0x63616c/split-flap/cad/export/renders/mirror-light-layout.png

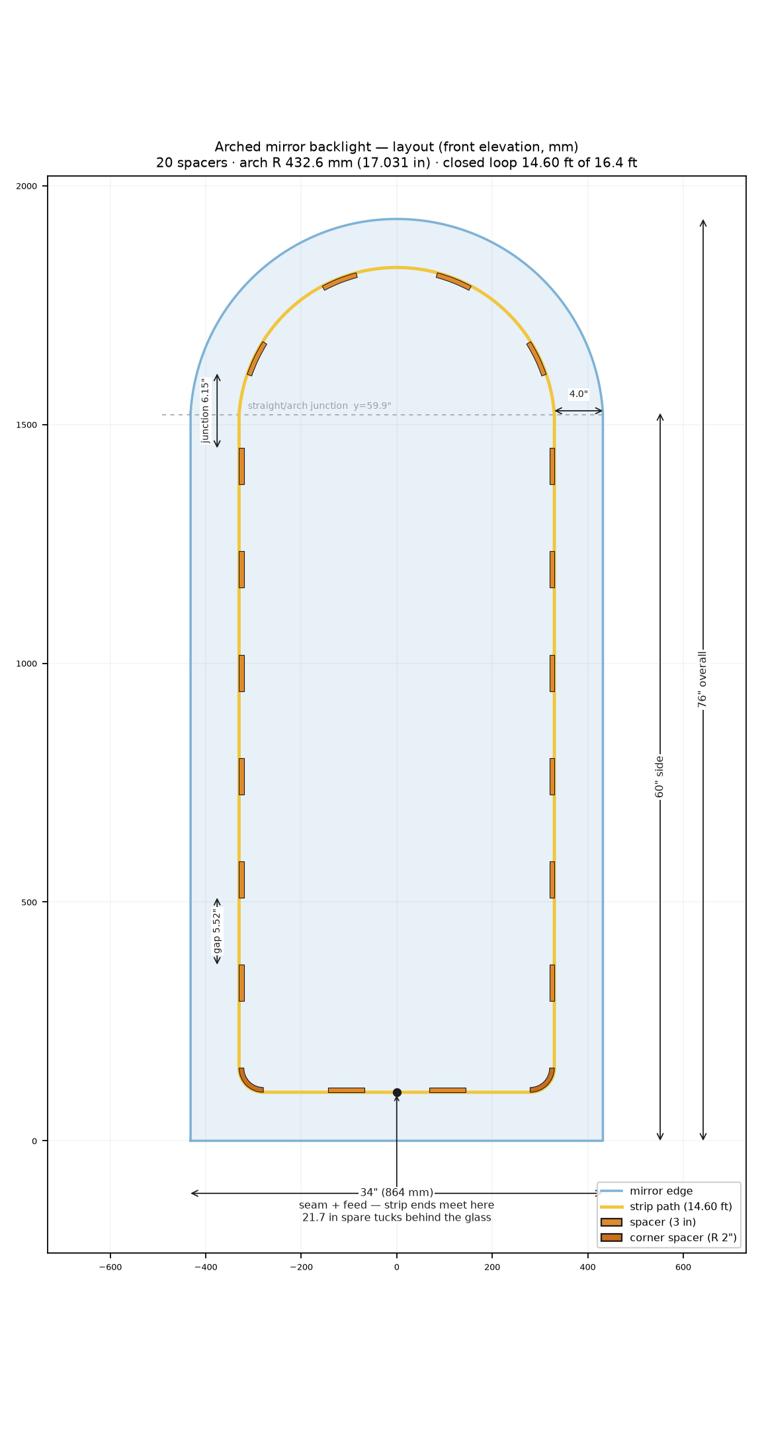
cad/export/renders/mirror-light-layout.png
