0x63616c/split-flap/cad/export/renders/mirror-light-section.png

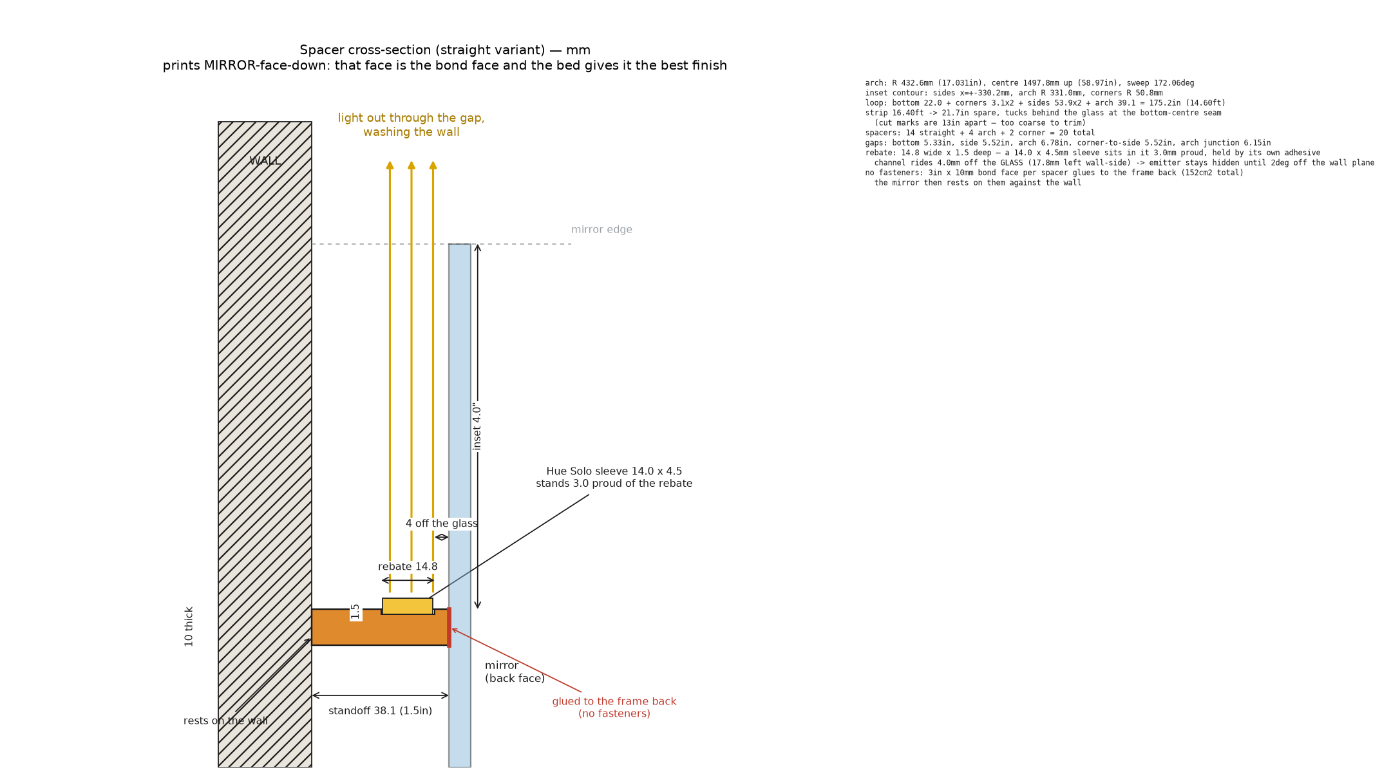
cad/export/renders/mirror-light-section.png
