0x63616c/split-flap/pcb/driver-board-nema/render/bottom.png

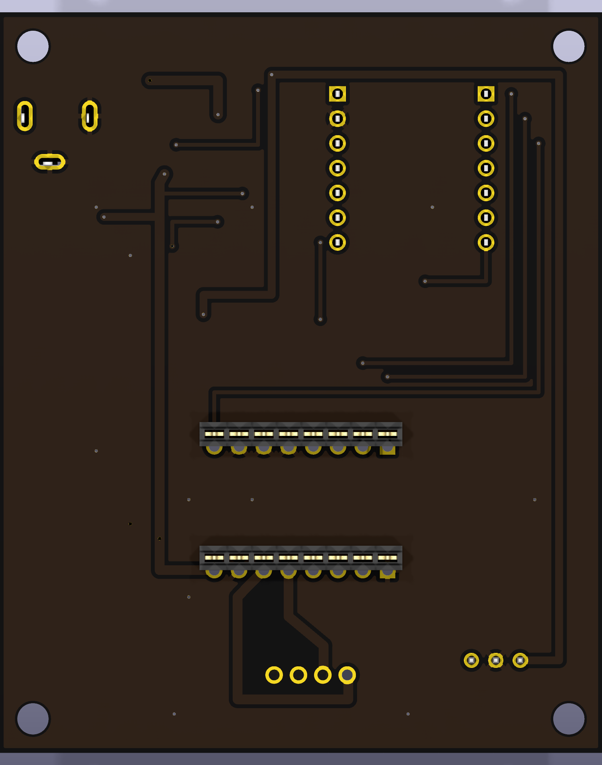
pcb/driver-board-nema/render/bottom.png
