0x63616c/split-flap/pcb/driver-board-nema/render/front.png

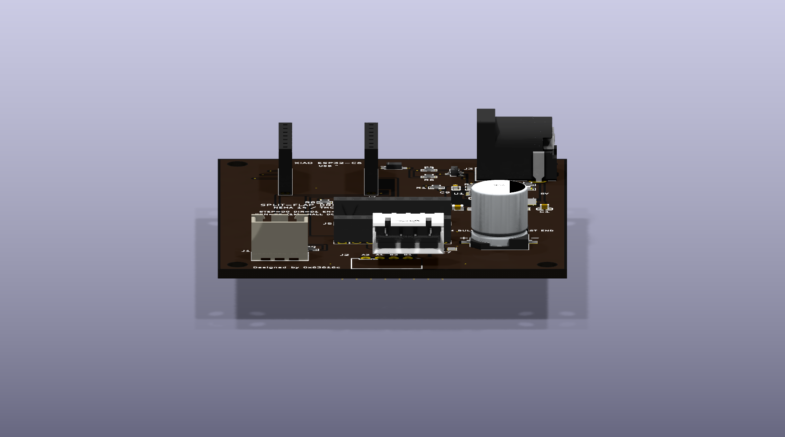
pcb/driver-board-nema/render/front.png
