0x63616c/split-flap/pcb/driver-board-nema/render/iso.png

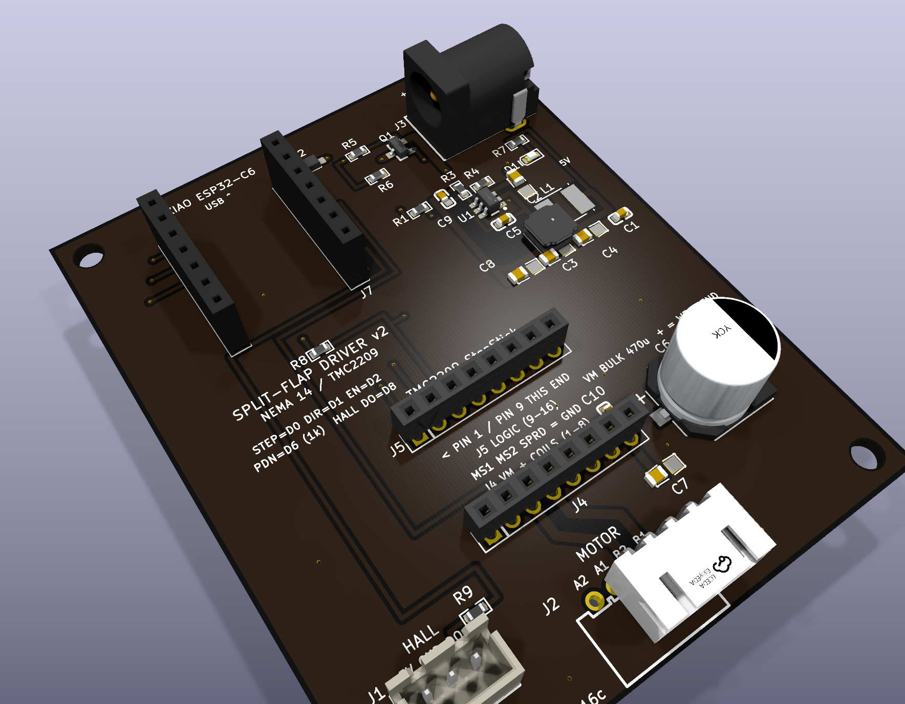
pcb/driver-board-nema/render/iso.png
