0x63616c/split-flap/pcb/driver-board/render/bottom.png

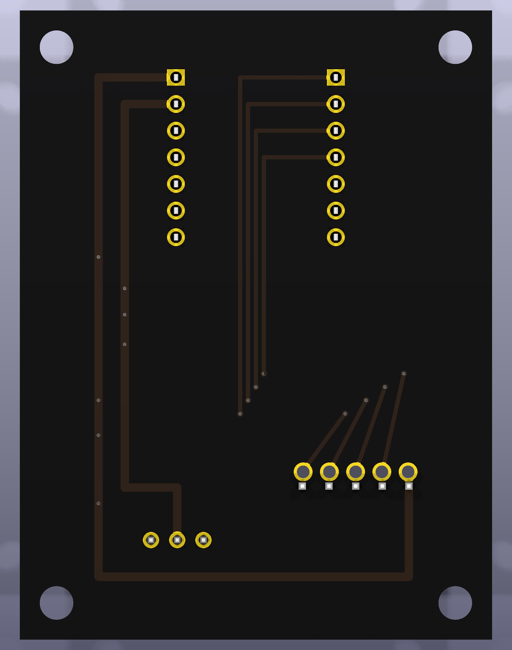
pcb/driver-board/render/bottom.png
