0x63616c/split-flap/pcb/driver-board/render/front.png

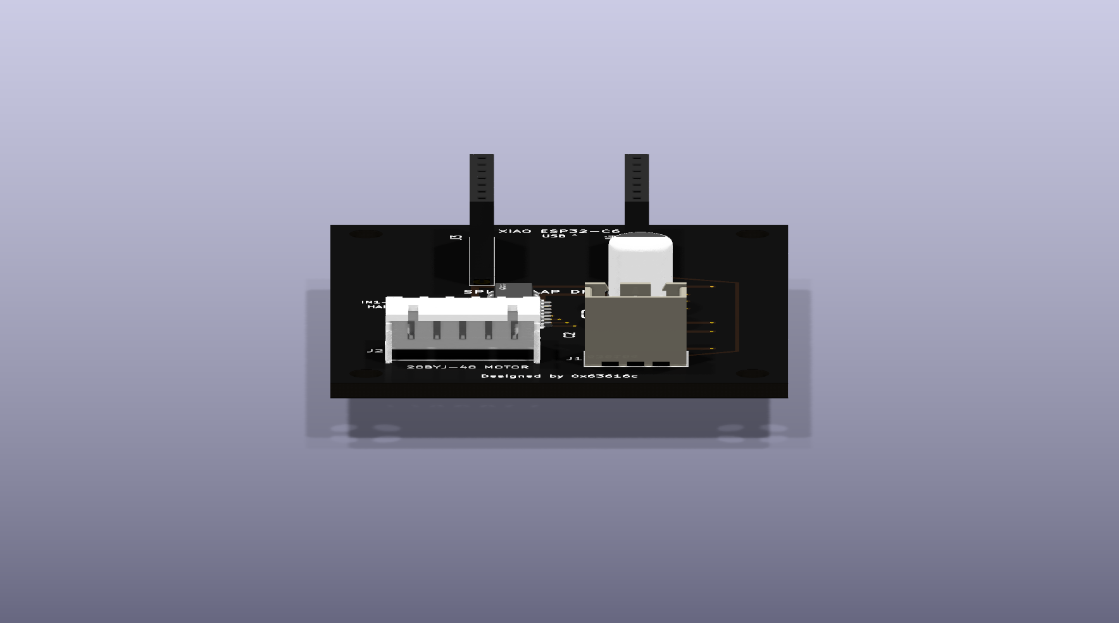
pcb/driver-board/render/front.png
