0x63616c/split-flap/pcb/driver-board/render/iso2.png

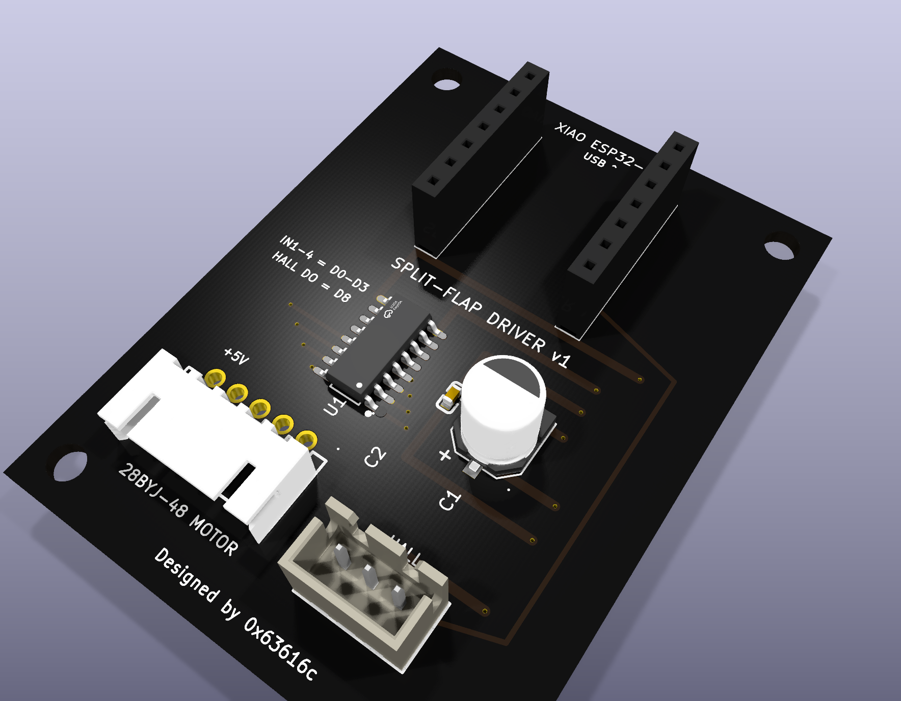
pcb/driver-board/render/iso2.png
