0x63616c/split-flap/pcb/driver-board/render/iso.png

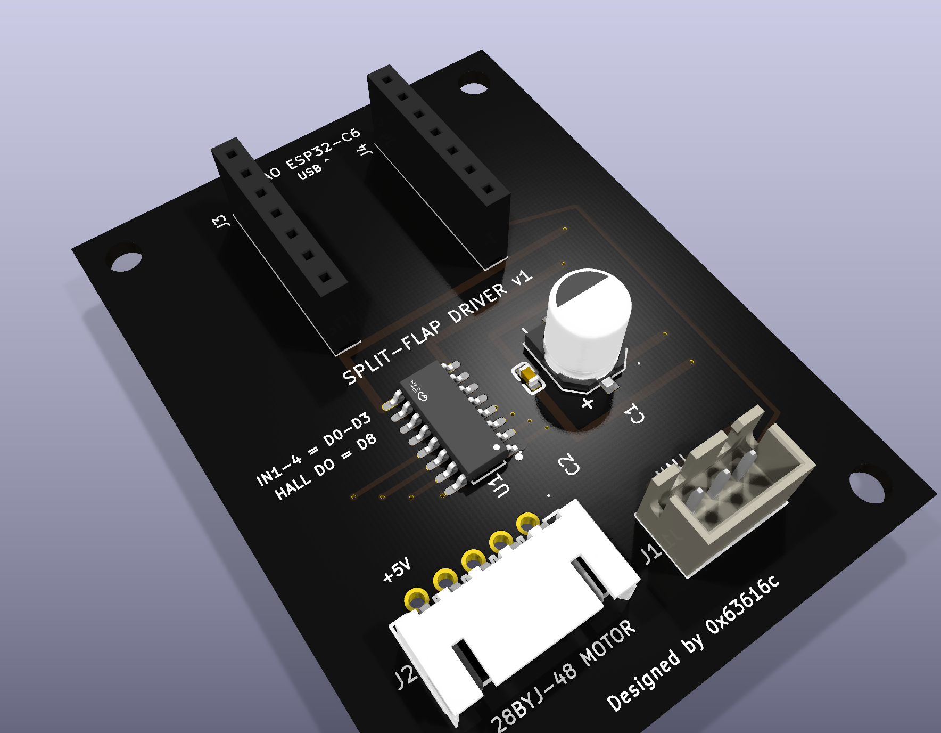
pcb/driver-board/render/iso.png
