0x63616c/split-flap/docs/inventory.md

# Inventory — supplies on hand

As of 2026-07-14. The BOM (`bom/module-bom.md`) reconciles against this list. Everything not listed here is to be 3D-printed on the P2S.

## Electronics / actuation

| Item | Qty | Notes |
|---|---|---|
| Seeed XIAO ESP32-C6 | ~2 | Controller. RISC-V, WiFi/BLE. 11 GPIO broken out (D0–D10), VBUS 5V pin, 3.3V-OUT, USB-C |
| ELEGOO 28BYJ-48 5V stepper + ULN2003 driver board | 5 sets | Drum drive |
| FORIOT A3144 / 3144E Hall-effect sensors | 10 | 3.3–5V; flap homing |
| ELEGOO 400-point solderless breadboards | 6 | Prototype wiring |
| Soldering iron set | 1 | In bag, contents unconfirmed |
| Klein Tools MM420 multimeter | 1 | Cheatsheet: `docs/reference/klein-mm420.md`, manual PDF alongside |

## Fasteners / hardware

| Item | Qty | Notes |
|---|---|---|
| M3 brass heat-set threaded inserts | 300 | M3 × 3–10 mm height, 4.5 mm OD; for printed parts |
| M3 button-head hex socket screws (assortment) | 1001 | 6/8/10/12/16/20/25/30 mm + nuts + washers, 10.9 alloy |
| rhinocats 6×3 mm round rare-earth magnets | 80 | Known magnet stock (other "small magnets" mentioned but unconfirmed) |

## Fabrication

| Item | Notes |
|---|---|
| Bambu Lab P2S printer | P1S-class; slicer is Bambu Studio |
| Filament | White + black |
