0x63616c/split-flap/cad/export/lid-clip.stl

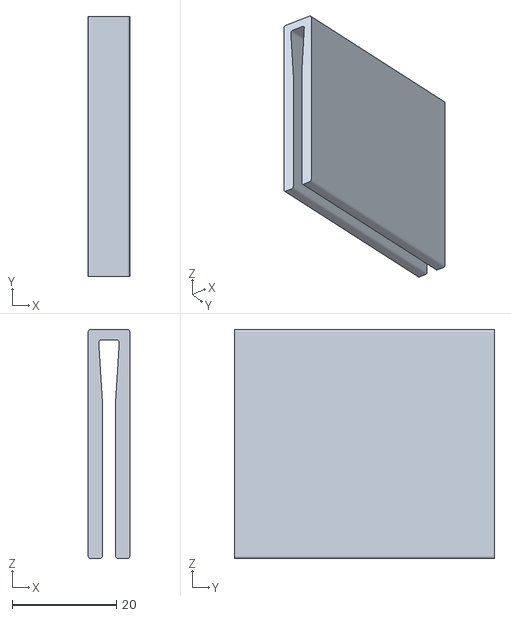
[picture p13: CAD file, 2026-07-22]
cad/export/lid-clip.stl
8.00 x 50.0 x 44.0
