0x63616c/split-flap/cad/export/plates/flaps_plate_4.3mf

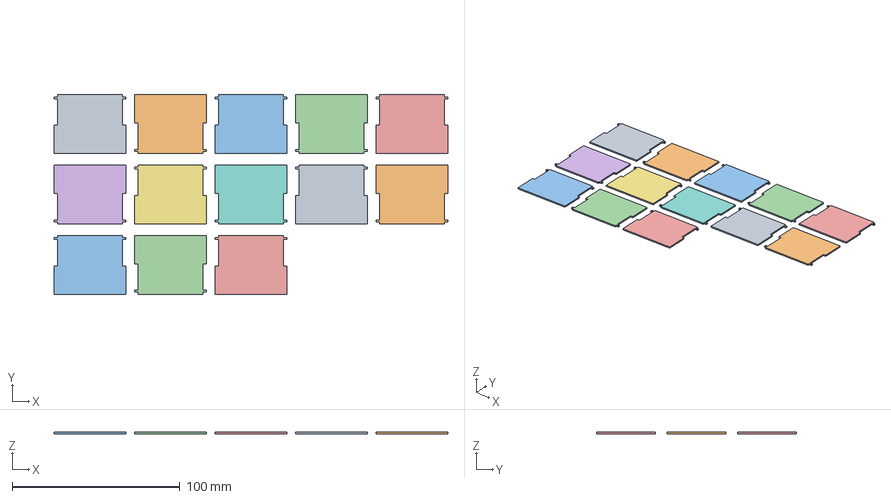
[picture p14: CAD file, 2026-07-22]
cad/export/plates/flaps_plate_4.3mf
235.0 x 119.0 x 1.00 mm
flap_39_hyphen_qmark
flap_40_qmark_bang
flap_41_bang_dollar
flap_42_dollar_gbp
flap_43_gbp_hash
flap_44_hash_pct
flap_45_pct_deg
flap_46_deg_apos
flap_47_apos_amp
flap_48_amp_slash
flap_49_slash_plus
flap_50_plus_comma
flap_51_comma_blank
