0x63616c/split-flap/cad/export/lid-clip-post.stl

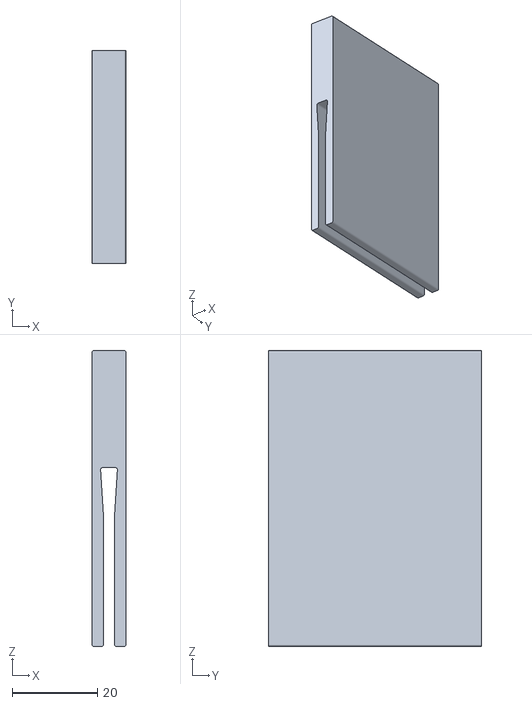
[picture p16: CAD file, 2026-07-22]
cad/export/lid-clip-post.stl
8.00 x 50.0 x 69.5
