0x63616c/split-flap/cad/export/plates/flaps_plate_2.3mf

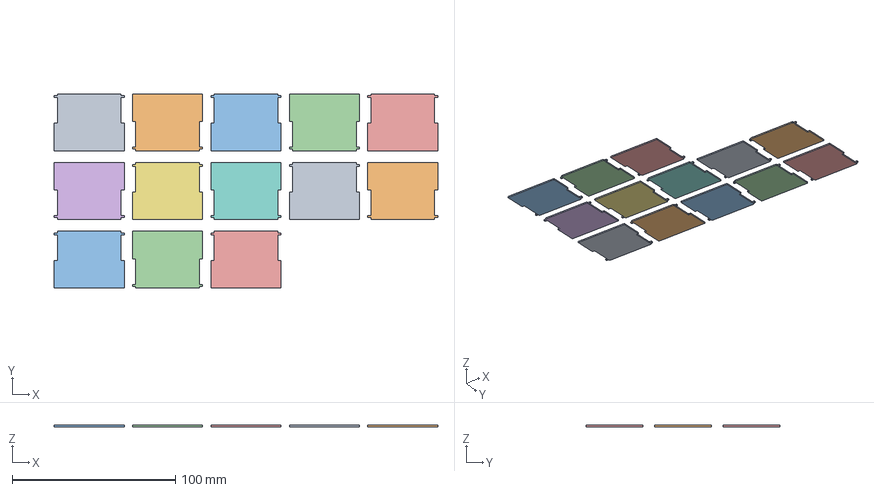
[picture p17: CAD file, 2026-07-22]
cad/export/plates/flaps_plate_2.3mf
235.0 x 119.0 x 1.00 mm
flap_13_MN
flap_14_NO
flap_15_OP
flap_16_PQ
flap_17_QR
flap_18_RS
flap_19_ST
flap_20_TU
flap_21_UV
flap_22_VW
flap_23_WX
flap_24_XY
flap_25_YZ
