0x63616c/split-flap/cad/export/box-corner.stl

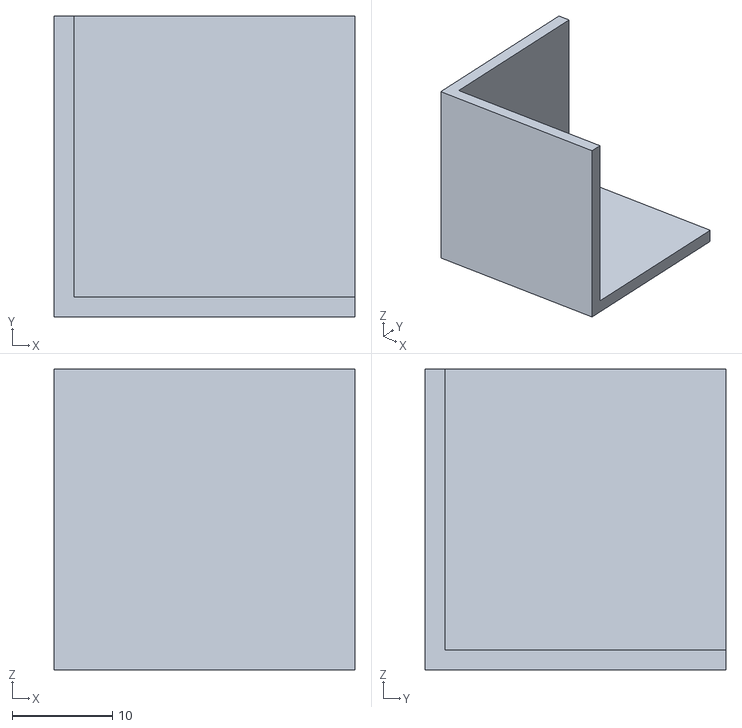
[picture p18: CAD file, 2026-07-22]
cad/export/box-corner.stl
30.0 x 30.0 x 30.0
