0x63616c/split-flap/cad/export/plates/flaps_plate_1.3mf

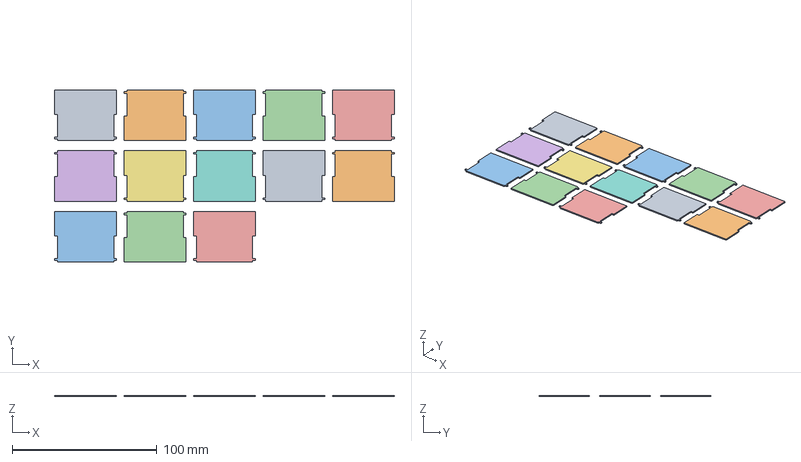
[picture p20: CAD file, 2026-07-22]
cad/export/plates/flaps_plate_1.3mf
235.0 x 119.0 x 1.00 mm
flap_00_blank_A
flap_01_AB
flap_02_BC
flap_03_CD
flap_04_DE
flap_05_EF
flap_06_FG
flap_07_GH
flap_08_HI
flap_09_IJ
flap_10_JK
flap_11_KL
flap_12_LM
