0x63616c/split-flap/cad/export/mirror-spacer-straight.stl

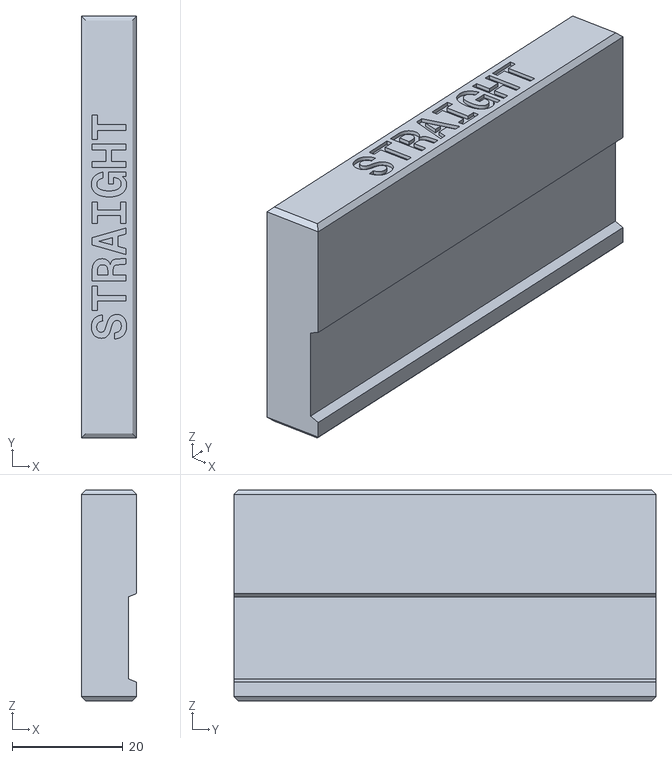
[picture p21: CAD file, 2026-07-21]
cad/export/mirror-spacer-straight.stl
10.0 x 76.2 x 38.1
