0x63616c/split-flap/cad/export/plates/flaps_plate_3.3mf

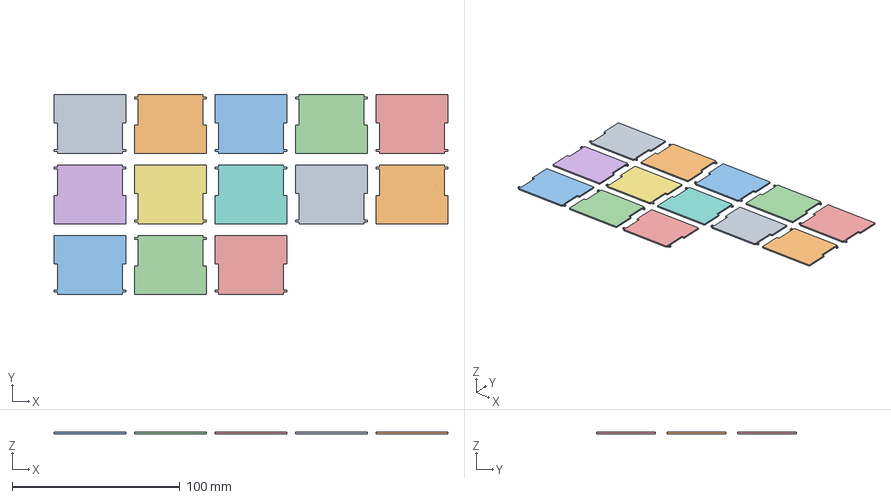
[picture p22: CAD file, 2026-07-17]
cad/export/plates/flaps_plate_3.3mf
235.0 x 119.0 x 1.00 mm
flap_26_Z0
flap_27_01
flap_28_12
flap_29_23
flap_30_34
flap_31_45
flap_32_56
flap_33_67
flap_34_78
flap_35_89
flap_36_9_colon
flap_37_colon_period
flap_38_period_hyphen
