0x63616c/split-flap/cad/export/mirror-spacer-arch.stl

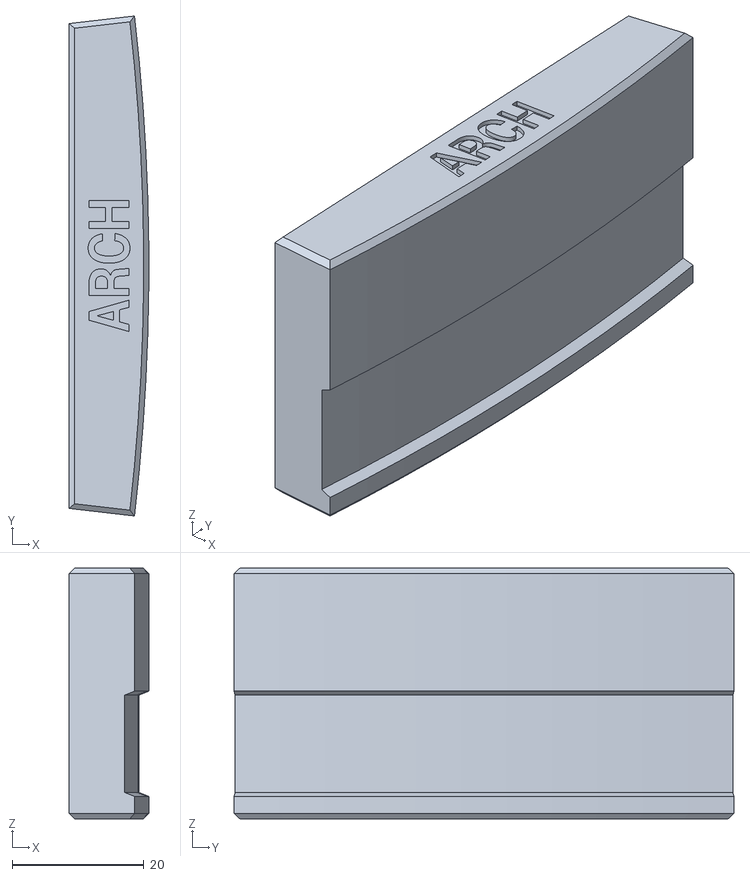
[picture p24: CAD file, 2026-07-21]
cad/export/mirror-spacer-arch.stl
12.1 x 76.0 x 38.1
