0x63616c/split-flap/cad/export/unit.stl

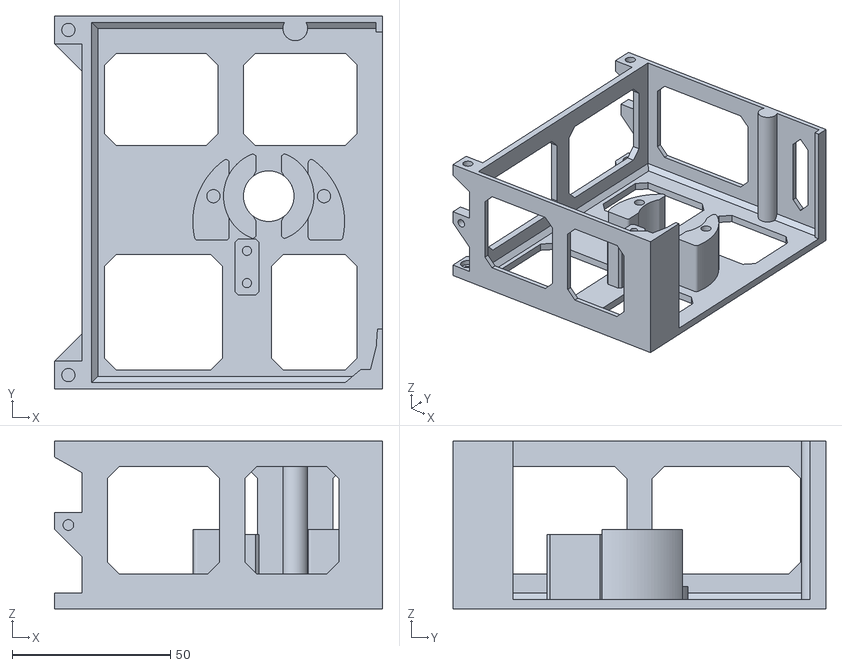
[picture p26: CAD file, 2026-07-21]
cad/export/unit.stl
103.8 x 118.0 x 53.0
