0x63616c/split-flap/cad/export/flaps/flap_22_VW.3mf

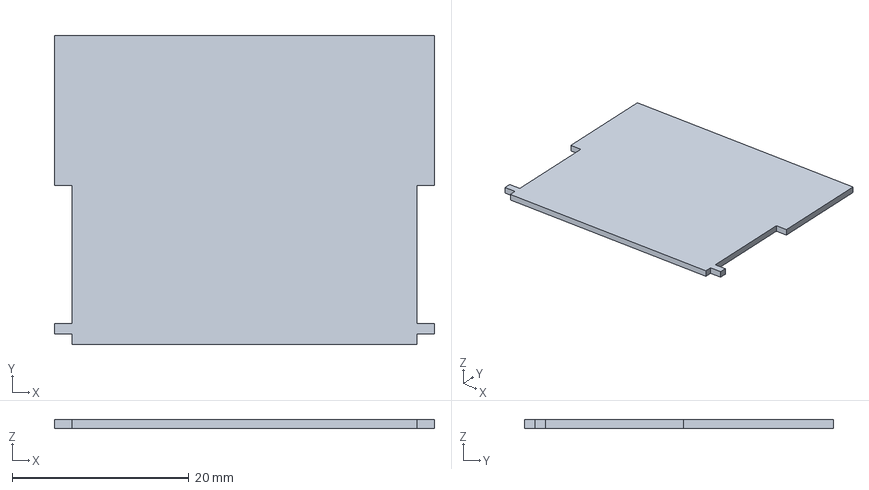
[picture p27: CAD file, 2026-07-18]
cad/export/flaps/flap_22_VW.3mf
43.0 x 35.0 x 1.00 mm
