0x63616c/split-flap/cad/export/mirror-spacer-corner.stl

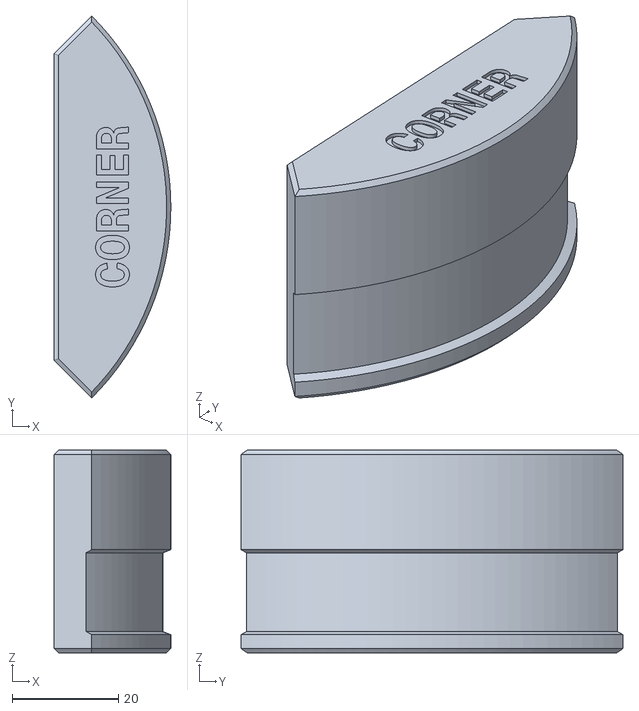
[picture p28: CAD file, 2026-07-21]
cad/export/mirror-spacer-corner.stl
22.0 x 71.8 x 38.1
