0x63616c/split-flap/cad/export/flaps/flap_23_WX.3mf

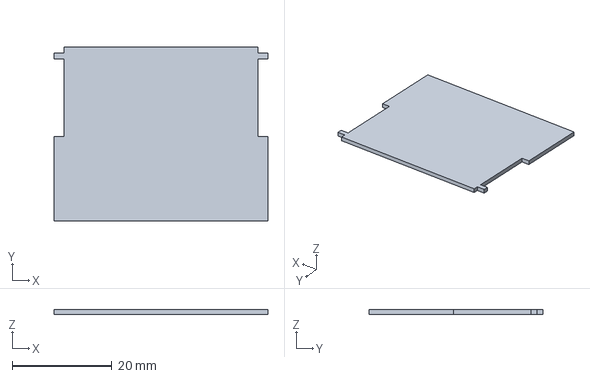
[picture p29: CAD file, 2026-07-17]
cad/export/flaps/flap_23_WX.3mf
43.0 x 35.0 x 1.00 mm
