0x63616c/split-flap/cad/export/poop-bucket.stl

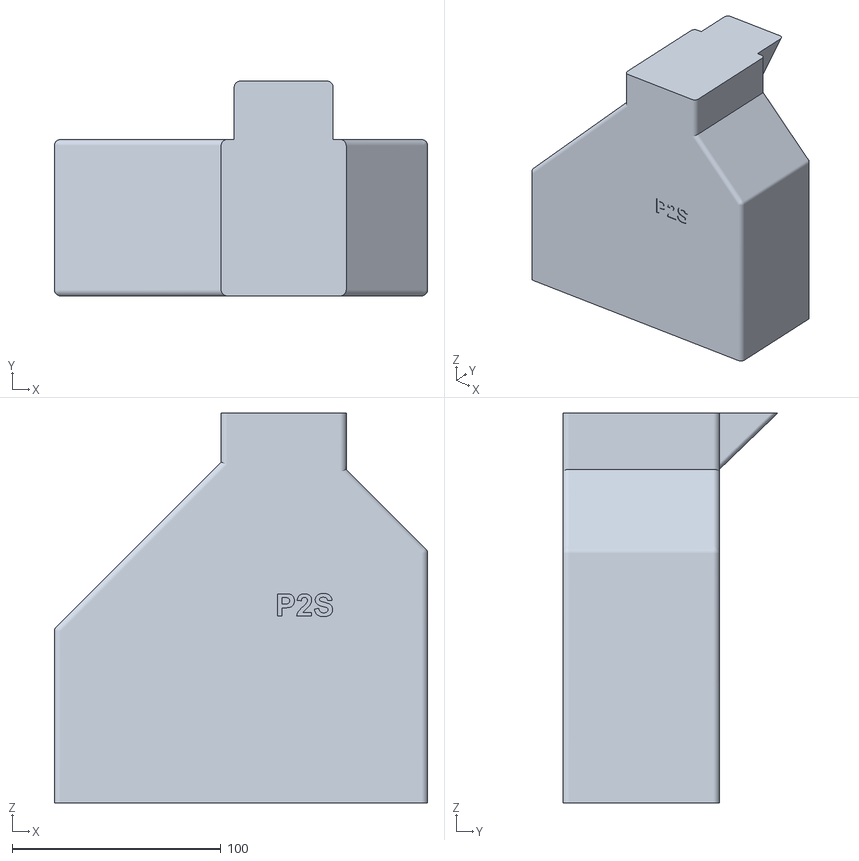
[picture p30: CAD file, 2026-07-19]
cad/export/poop-bucket.stl
179.0 x 103.0 x 187.0
