0x63616c/split-flap/cad/export/grommet-bathroom.stl

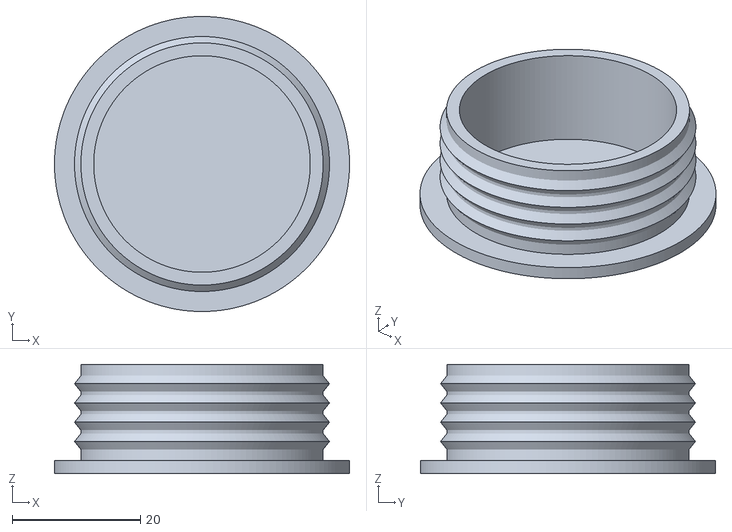
[picture p31: CAD file, 2026-07-19]
cad/export/grommet-bathroom.stl
46.0 x 46.0 x 17.0
