0x63616c/split-flap/cad/export/unit-nema.stl

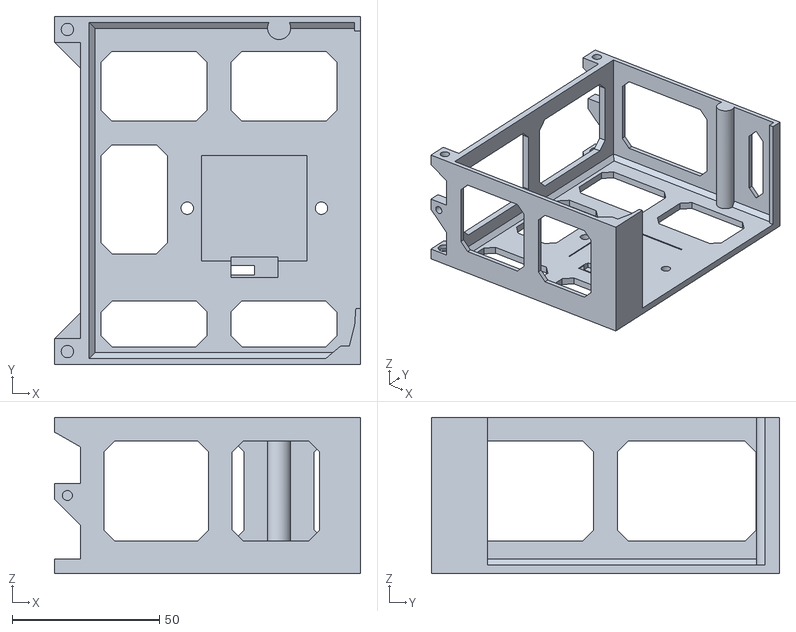
[picture p33: CAD file, 2026-07-18]
cad/export/unit-nema.stl
103.8 x 118.0 x 53.0
