0x63616c/split-flap/cad/export/bridge-nema.stl

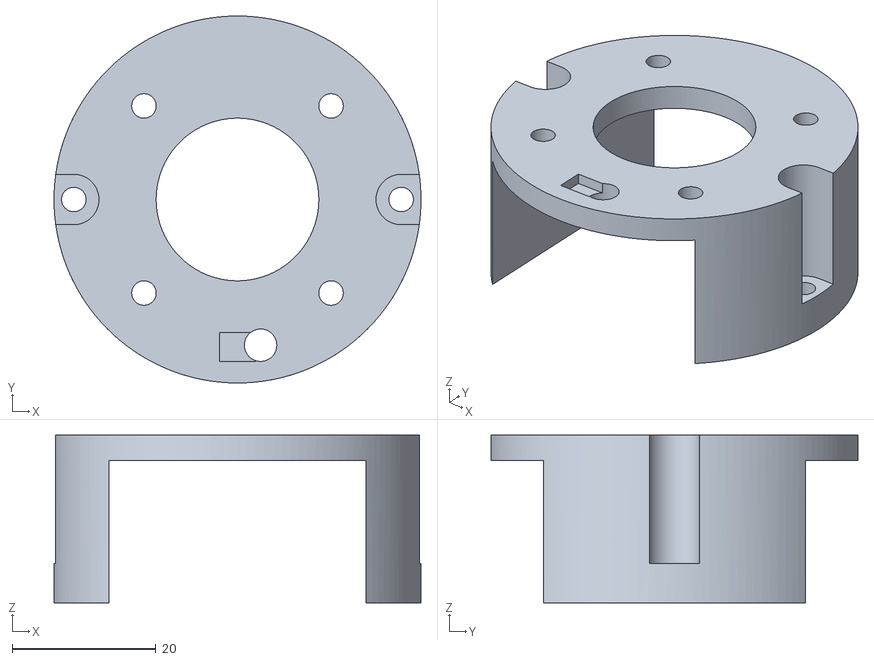
[picture p34: CAD file, 2026-07-18]
cad/export/bridge-nema.stl
51.0 x 51.0 x 23.3
