0x63616c/split-flap/cad/export/drum-inner-nema.stl

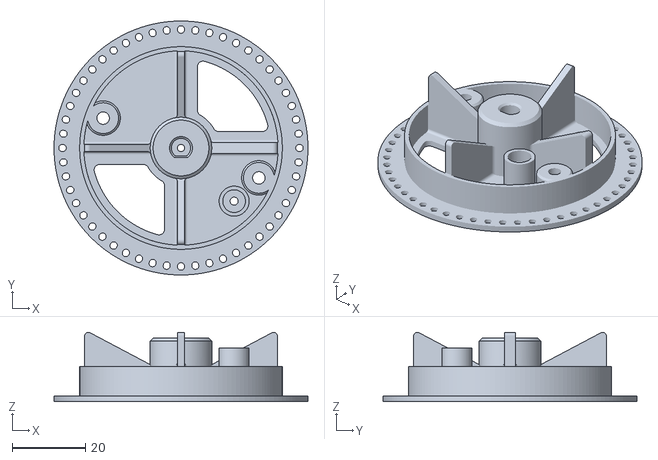
[picture p36: CAD file, 2026-07-18]
cad/export/drum-inner-nema.stl
69.3 x 69.3 x 18.9
