0x63616c/split-flap/cad/export/flaps/flap_16_PQ.3mf

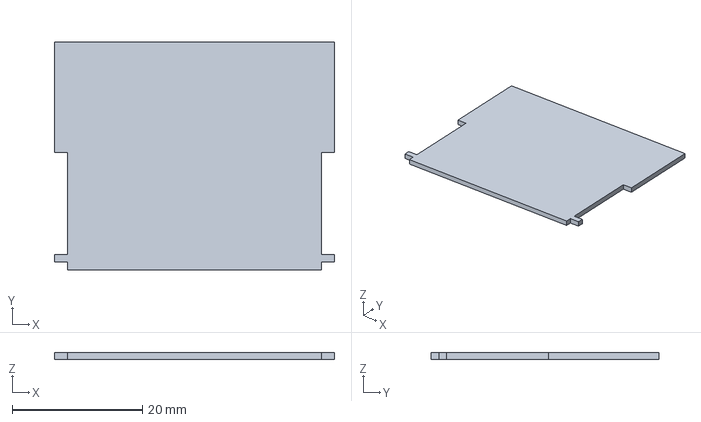
[picture p37: CAD file, 2026-07-17]
cad/export/flaps/flap_16_PQ.3mf
43.0 x 35.0 x 1.00 mm
