0x63616c/split-flap/cad/export/grommet-usb.stl

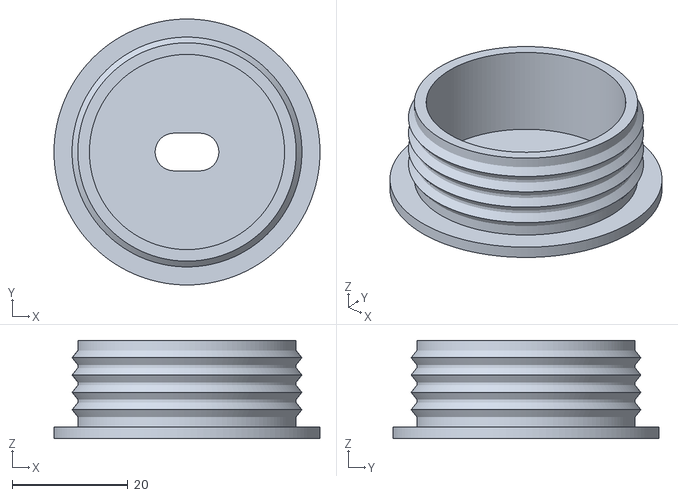
[picture p38: CAD file, 2026-07-18]
cad/export/grommet-usb.stl
46.0 x 46.0 x 17.0
