0x63616c/split-flap/cad/export/ipad-lid.stl

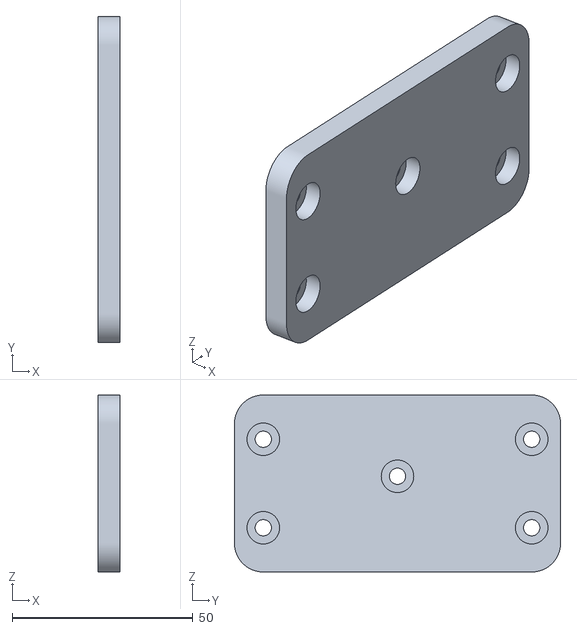
[picture p40: CAD file, 2026-07-17]
cad/export/ipad-lid.stl
6.00 x 90.3 x 49.0
