0x63616c/split-flap/cad/export/ipad-body.stl

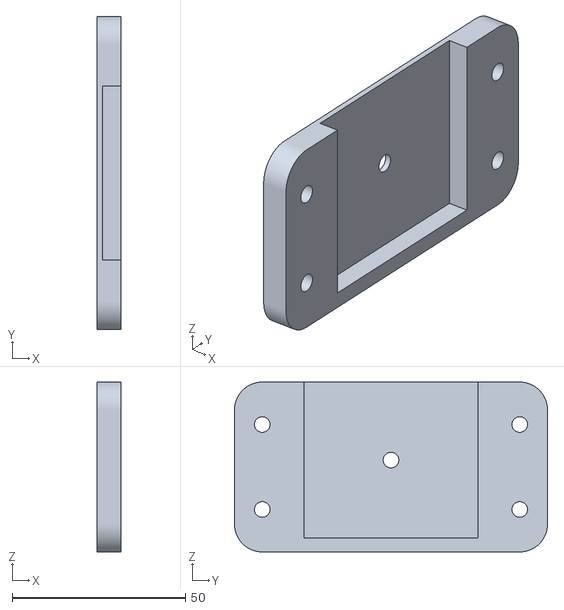
[picture p42: CAD file, 2026-07-17]
cad/export/ipad-body.stl
6.80 x 90.3 x 49.0
