0x63616c/split-flap/cad/export/ipad-bracket.stl

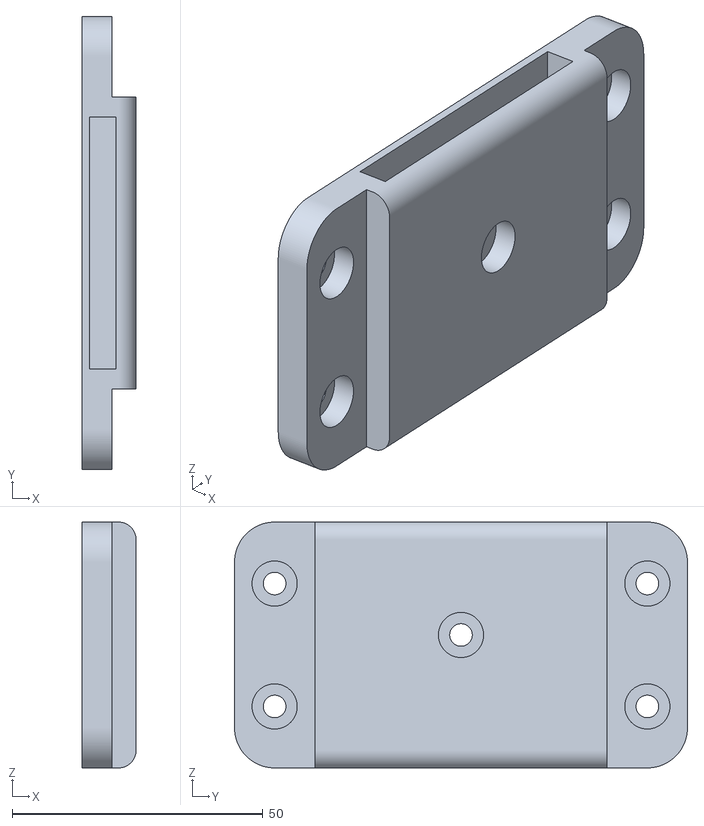
[picture p43: CAD file, 2026-07-17]
cad/export/ipad-bracket.stl
10.8 x 90.3 x 49.0
