0x63616c/split-flap/cad/export/drum-outer.stl

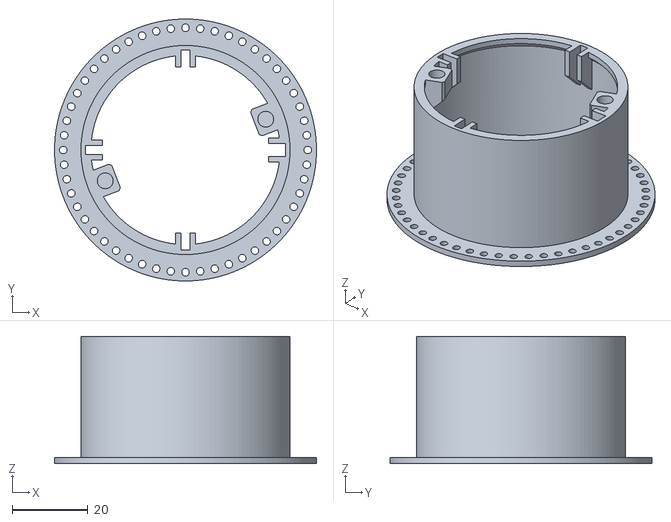
[picture p44: CAD file, 2026-07-17]
cad/export/drum-outer.stl
69.3 x 69.3 x 33.6
