0x63616c/split-flap/cad/export/holder.stl

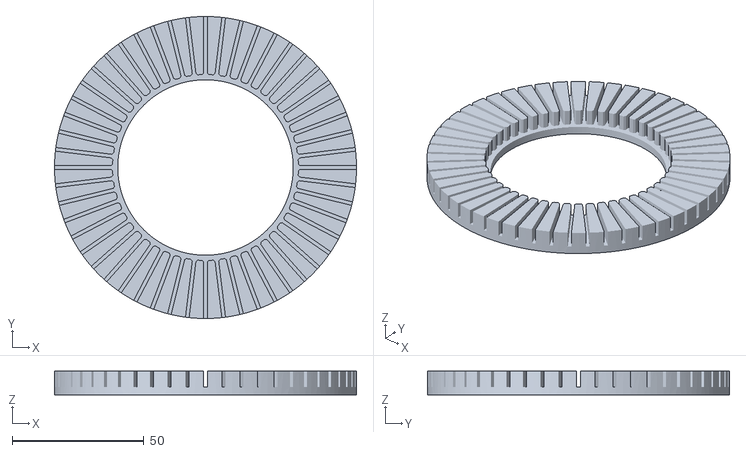
[picture p46: CAD file, 2026-07-17]
cad/export/holder.stl
114.5 x 114.5 x 9.00
