0x63616c/split-flap/cad/export/flap.stl

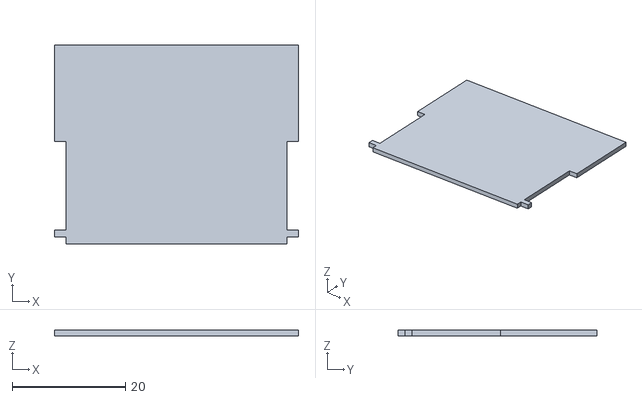
[picture p47: CAD file, 2026-07-16]
cad/export/flap.stl
43.0 x 35.0 x 1.00
