0x63616c/split-flap/cad/export/flaps/flap_45_pct_deg.3mf

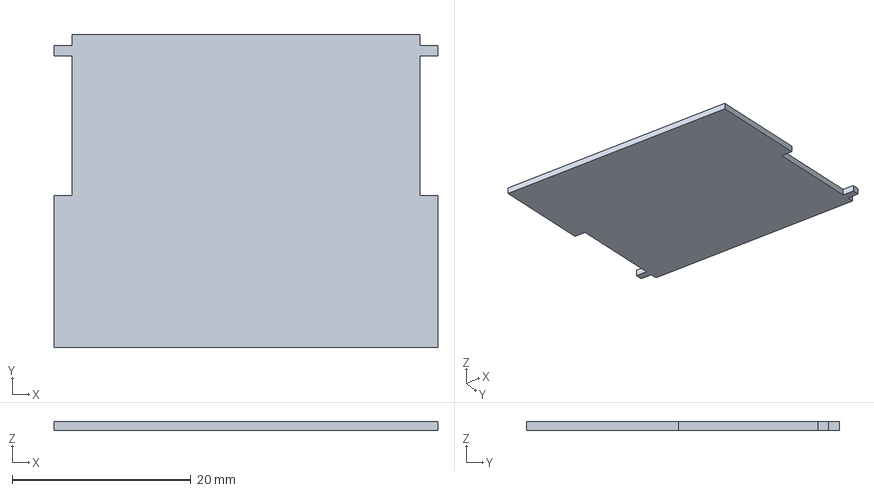
[picture p49: CAD file, 2026-07-17]
cad/export/flaps/flap_45_pct_deg.3mf
43.0 x 35.0 x 1.00 mm
