0x63616c/split-flap/cad/export/flaps/flap_48_amp_slash.3mf

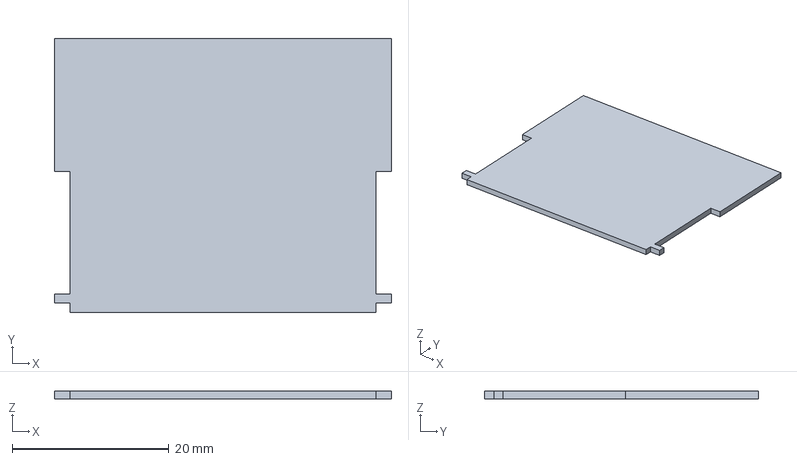
[picture p51: CAD file, 2026-07-17]
cad/export/flaps/flap_48_amp_slash.3mf
43.0 x 35.0 x 1.00 mm
