0x63616c/split-flap/(list of files, cad)

Other CAD files:
cad/export/flaps/flap_21_UV.3mf
cad/export/flaps/flap_31_45.3mf
cad/export/flaps/flap_03_CD.3mf
cad/export/drum-inner-byj.stl
cad/export/flaps/flap_27_01.3mf
cad/export/flaps/flap_49_slash_plus.3mf
cad/export/flaps/flap_47_apos_amp.3mf
cad/export/flaps/flap_15_OP.3mf
cad/export/flaps/flap_19_ST.3mf
cad/export/flaps/flap_06_FG.3mf
cad/export/flaps/flap_51_comma_blank.3mf
cad/export/flaps/flap_42_dollar_gbp.3mf
cad/export/flaps/flap_05_EF.3mf
cad/export/flaps/flap_24_XY.3mf
cad/export/flaps/flap_30_34.3mf
cad/export/flaps/flap_26_Z0.3mf
cad/export/flaps/flap_32_56.3mf
cad/export/flaps/flap_43_gbp_hash.3mf
cad/export/flaps/flap_28_12.3mf
cad/export/flaps/flap_37_colon_period.3mf
cad/export/flaps/flap_36_9_colon.3mf
cad/export/flaps/flap_18_RS.3mf
cad/export/flaps/flap_44_hash_pct.3mf
cad/export/flaps/flap_07_GH.3mf
cad/export/flaps/flap_09_IJ.3mf
cad/export/flaps/flap_11_KL.3mf
cad/export/flaps/flap_01_AB.3mf
cad/export/flaps/flap_35_89.3mf
cad/export/flaps/flap_08_HI.3mf
cad/export/flaps/flap_17_QR.3mf
cad/export/flaps/flap_38_period_hyphen.3mf
cad/export/flaps/flap_41_bang_dollar.3mf
cad/export/flaps/flap_04_DE.3mf
cad/export/flaps/flap_34_78.3mf
cad/export/flaps/flap_20_TU.3mf
cad/export/flaps/flap_02_BC.3mf
