0x63616c/split-flap/pcb/driver-board-nema/layouts/default/default.kicad_pcb

## KiCad design pcb/driver-board-nema/layouts/default/default.kicad_pcb (2026-07-19)

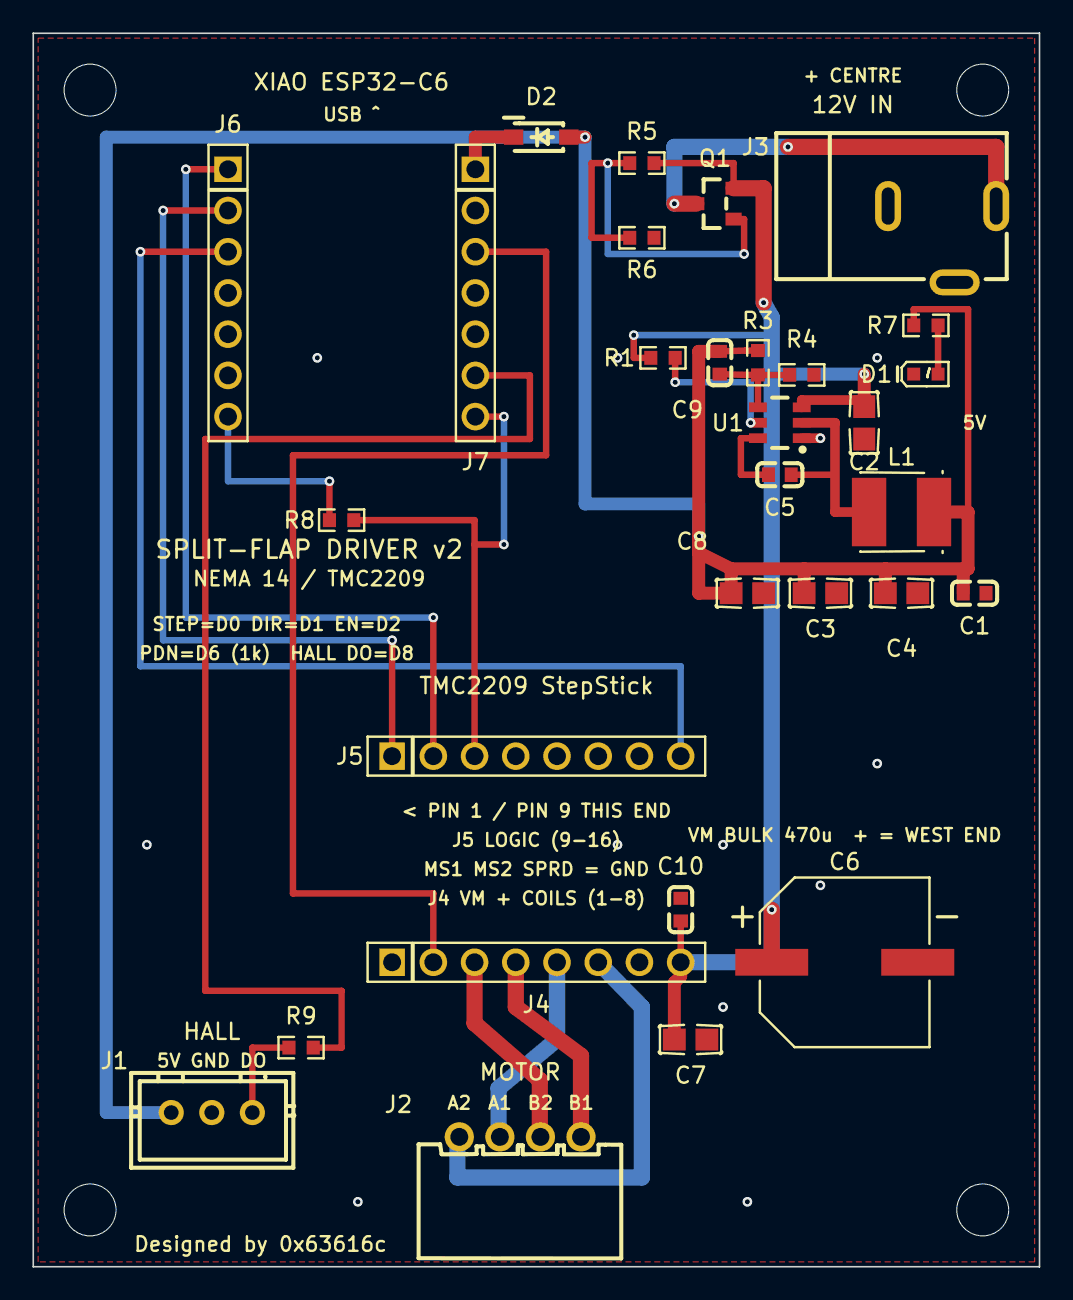
[picture p52: board pcb/driver-board-nema/layouts/default/default.kicad_pcb from above]

Board: 2 copper layers, 62.0 x 76.0 mm, 30 parts (0 on the bottom side), 23 nets.

Parts:
C1, C5, C9, C10: C0603
C2, C3, C4, C7, C8: C0805
C6: CAP-SMD_BD10.0-L10.3-W10.3-LS11.0-FD
D1: LED0603-RD
D2: SOD-123_L2.7-W1.6-LS3.7-RD-1
J1: CONN-TH_3P-P2.50_A2501WV2-3P
J2: CONN-TH_XH2.54-4AW
J3: DC-IN-TH_DC-005C-20A
J4, J5: HDR-TH_8P-P2.54-V-F
J6, J7: HDR-TH_7P-P2.54-V-F
L1: IND-SMD_L5.0-W5.0
Q1: SOT-23_L2.9-W1.3-P1.90-LS2.4-BR
R1, R3, R4, R5, R6, R7, R8, R9: R0603
U1: SOT-23-6_L2.9-W1.6-P0.95-LS2.8-BR

Connections:
1: C1.1, C3.1, C4.1, C8.1, C9.1, D2.2, J1.1, L1.1, R3.1, R7.1
1-1: C2.1, C6.1, C7.1, C10.1, J4.8, Q1.2, R1.1, R5.2, U1.3
1-2: Q1.1, R5.1, R6.1
1-3: J6.7, R8.1
2: C1.2, C2.2, C3.2, C4.2, C6.2, C7.2, C8.2, C10.2, D1.1, J1.2, J3.2, J3.3, J4.1, J4.7, J5.5, J5.6, J5.7, J7.2, R4.2, R6.2, U1.1
2-1: C5.2, L1.2, U1.2
2-2: D1.2, R7.2
dir: J5.1, J6.2
en_n: J5.8, J6.3
hall_do: J7.6, R9.2
hall_raw: J1.3, R9.1
m1a: J2.1, J4.4
m1b: J2.2, J4.3
m2a: J2.3, J4.5
m2b: J2.4, J4.6
p3v3: J4.2, J7.3
p5v_xiao: D2.1, J7.1
pdn: J5.3, J7.7, R8.2
step: J5.2, J6.1
v12_raw: J3.1, Q1.3
vbst: C5.1, U1.6
ven: R1.2, U1.5
vfb: C9.2, R3.2, R4.1, U1.4
