0x63616c/split-flap/pcb/driver-board/layouts/default/default.kicad_pcb

## KiCad design pcb/driver-board/layouts/default/default.kicad_pcb (2026-07-19)

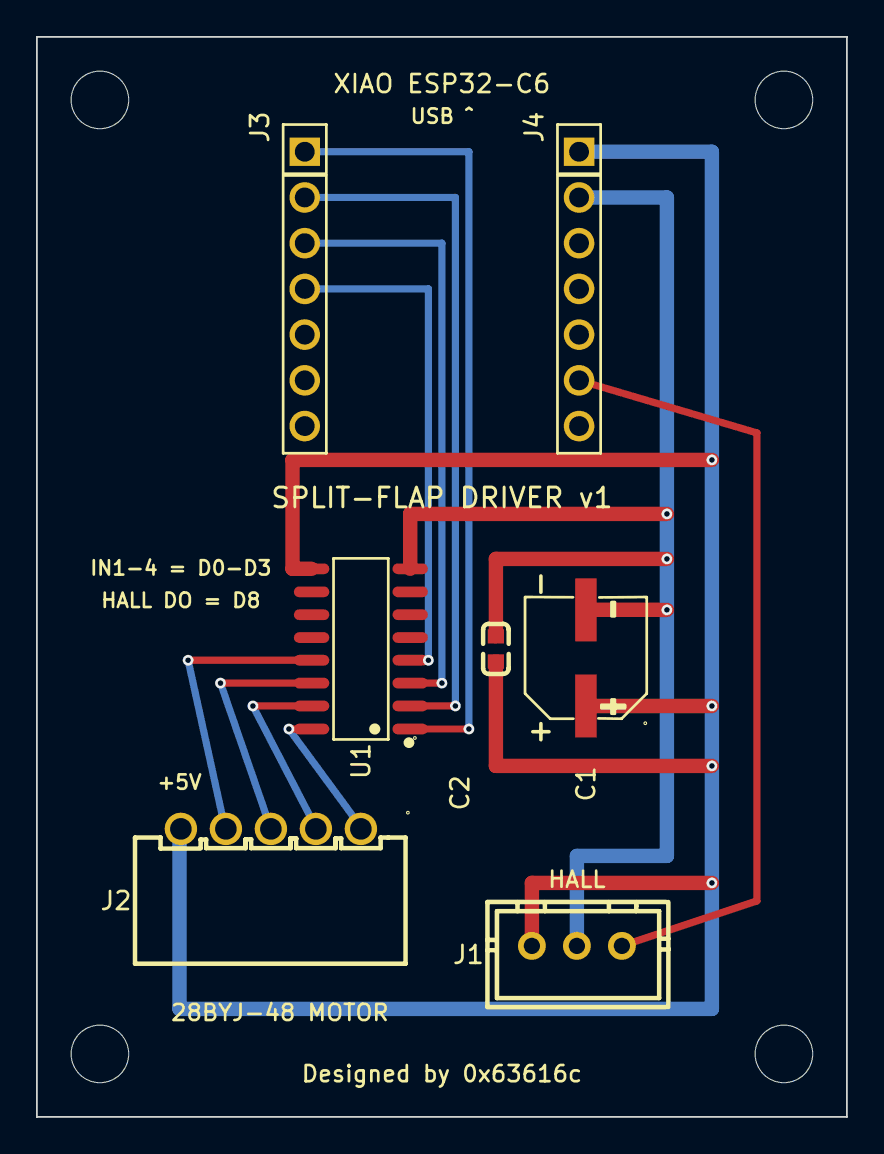
[picture p53: board pcb/driver-board/layouts/default/default.kicad_pcb from above]

Board: 2 copper layers, 45.0 x 60.0 mm, 7 parts (0 on the bottom side), 11 nets.

Parts:
C1: CAP-SMD_BD6.3-L6.6-W6.6-FD
C2: C0603
J1: CONN-TH_3P-P2.50_A2501WV2-3P
J2: CONN-TH_XH2.54-5AW
J3, J4: HDR-TH_7P-P2.54-V-F
U1: SOIC-16_L9.9-W3.9-P1.27-LS6.0-BL

Connections:
1: C1.1, C2.1, J1.1, J2.5, J4.1, U1.9
1-1: J3.1, U1.1
1-2: J2.1, U1.16
2: C1.2, C2.2, J1.2, J4.2, U1.8
2-1: J3.2, U1.2
3: J3.3, U1.3
4: J3.4, U1.4
13: J2.4, U1.13
14: J2.3, U1.14
15: J2.2, U1.15
hall_do: J1.3, J4.6
