0x63616c/split-flap/(commit log)

2026-07-14 docs: CAD tool research — recommend build123d (#2)
2026-07-15 docs: repo scaffold + inventory and starter BOM (#4)
    Add firmware/, cad/, bom/ directories; docs/inventory.md capturing
    on-hand supplies; bom/module-bom.md starter BOM with have/need/print
    status per line item.
2026-07-15 firmware: MicroPython bench spike — spin, home, hall, beep
    Throwaway prototype proving breadboard hardware (XIAO ESP32-C6 + ULN2003 +
    28BYJ-48 + A3144). Not the final firmware stack (#5). Verified: USB flash,
    motor both dirs (~18 RPM unloaded ceiling), hall homing input, motor-as-buzzer.
    Ref #9.
2026-07-15 docs: breadboard wiring diagram + pin map (#9)
2026-07-15 docs: hall sensor is HW-477 module (LED + pot), not bare A3144
2026-07-15 docs: correct hall sensor — it LATCHES, homing needs 2-magnet setup
2026-07-15 bom: hall is latching (2 magnets/home), VBUS ok for prototype, bench-verified notes
2026-07-15 docs: hall is a unipolar switch after all — latch was an oversized-magnet artifact
    Revert the two-magnet homing change. Single magnet works; keep it small with a
    sensible air gap so the field clears the release threshold between passes.
2026-07-15 feat(bench): home calibration — nudge offset, home glyph, settle-to-blank
    Adds per-module home calibration to the throwaway bench stack so a freshly
    assembled module can be told where "home" is and which glyph sits there.
    Firmware (bench_board.py):
    - HOME now seeks the hall edge then steps a saved offset onto the home flap
    - NUDGE <±n> moves n half-steps and bakes it into the offset (persisted on the
    board in home_offset.txt, survives reboot/reflash)
    - OFFSET / RESET to report and wipe the offset
    Bench UI (bench_ui.py + slotplan.py):
    - slotplan gains HOME_INDEX: declare which glyph the home flap shows; rotates
    the whole glyph<->slot map with no motor cost
    - .sethome <g> (host-persis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
    [bench_board.py]
2026-07-16 feat(cad): build123d workspace with live-viewer dev loop
    - cad/: uv package `splitflap_cad` — params.py as single dimension
    source, flap/drum/unit/motor/28BYJ-48 builders, assembly, model
    catalog, vendor Unit.stp ghost overlay; tests for catalog + flap
    - tools/cad/up.sh + `just cad`: idempotent dev loop — two ocp_vscode
    viewers (assembly :3939, focus :3940), save-watcher rebuilds and
    re-pushes both, focus pane auto-follows last-saved part
    - `just export <part>`: STL to cad/export/
    - CLAUDE.md: document CAD dev loop and conventions
2026-07-16 feat(bench): step-accurate moves — ramping, hall resync, slow homing
    Open-loop 28BYJ-48 drops steps when slammed to cruise speed, and any
    dropped step is lost until the next home. Two firmware guards:
    - trapezoidal ramp (SLOW_US -> cruise -> SLOW_US over RAMP_STEPS) at
    both ends of every move
    - resync-on-pass: snap the step counter to the hall edge whenever a
    move sweeps the magnet — free re-zeroing between explicit homes;
    GOTO reports the correction as resync=<n> and gains a `slow` arg
    home() reworked: constant SLOW_US crawl for a crisp repeatable hall
    trip, CLEAR_MARGIN back-off when starting inside the field, one
    continuous phase counter so back-off -> seek never jerks the coi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
    [bench_board.py]
2026-07-16 feat(cad): plate lightening windows sized off neighbouring features
2026-07-16 docs: tighten CLAUDE.md further
2026-07-16 feat(cad): indexed guide ring + flanking rails, plate-only model
2026-07-16 feat(cad): guide rails 3x deeper than ring
    Rails now grab 4.5mm of the fin flank radially (was 1.5). Guide ring
    stays at 1.5: any deeper and the full annulus hits the inner web's
    magnet boss (sweeps r 22.1, overlaps the ring band axially). Rails sit
    at the fin angles so the 45-deg boss clears them.
2026-07-16 feat(cad): rotate assembly drum parts 180deg
2026-07-16 feat(cad): drop top chamfer on hall sensor post
2026-07-16 feat(cad): homing magnet 4mm further out (r 17.5 -> 21.5)
    Boss standoff drops 9.0 -> 7.5: at the new radius the boss bottom would
    land inside the outer part's guide-ring band (face r 25.0), so it must
    stop above the butt joint. Magnet face sits 1.6mm further from the hall
    sensor as a result.
2026-07-16 feat(cad): unify commands under 'just cad', export all, track STL exports
    - bare 'just cad' prints help; dev loop is now 'just cad dev [model]'
    - 'just cad export' with no arg writes every printable STL
    - fold cad-install/cad-test/export into 'just cad install|test|export'
    - stop gitignoring cad/export/ — commit the STLs
    [drum-inner.stl, drum-outer.stl, flap.stl, unit.stl]
2026-07-16 feat(cad): own motor screw towers with heat-set inserts
    Curved arm per ear: rect bound ∩ flap-swing arc − can relief. M3
    heat-set bores replace the vendor's trapped-nut slots.
    [params.py]
2026-07-16 feat(cad): magnet boss under guide ring — r 20.5, standoff 10
    Full 10mm standoff back. Boss wall thinned to 1.0/side (new
    drum_magnet_boss_wall param): boss outer edge 24.6 passes the guide
    ring face (25.0) with 0.4 clearance, so the boss may ride inside the
    ring band. Radius capped at 20.5 by that same edge.
    [drum.py, params.py]
2026-07-16 feat(cad): magnet standoff 11
2026-07-16 feat(cad): magnet standoff 13
2026-07-16 docs(cad): README to new 'just cad <cmd>' scheme
2026-07-16 refactor(cad): drop tower top chamfer, refresh STL exports
    [drum-inner.stl, unit.stl]
2026-07-16 feat(cad): hall mount follows magnet radius
    hall_near_gap raw 11.0 -> derived from drum_magnet_r minus new
    hall_elem_hole_off (6.5, back-computed from the r 17.5 layout), so the
    element stays under the magnet sweep when the boss moves.
2026-07-16 fix(cad): export drum-inner right-side up
    _p_drum_inner exported the part in its own frame, where the hub, barrel
    and fins hang into -Z below the bed — the STL came out upside down. Flip
    it 180 about X (as the catalog viewer already does) so the web sits flat
    on the bed and the barrel points up.
    [drum-inner.stl]
2026-07-16 feat(cad): fillet magnet boss root at the web
    Round the ring where the magnet boss OD meets the web underside so the
    boss isn't a sharp-rooted stress riser. New param drum_magnet_boss_fillet
    (1.0). Edge picked by circle centre + boss radius so the poke-hole ring
    is left alone.
    [drum-inner.stl]
2026-07-16 feat(cad): fillet fin roots against the web underside
    [unit.stl]
2026-07-16 fix(cad): fin web-root + hub fillets in one call
    Sequential fillets failed where the root fillet met the fin/hub
    junction edges — OCC blends shared corners only within a single fillet
    operation. One radius (drum_fin_hub_fillet) covers both.
    [drum.py, params.py]
2026-07-16 fix(cad): drum-inner fillet cleanup
    Two fixes to drum_inner's fillet pass:
    - Remove the magnet-boss root fillet (added earlier this session): not
    wanted.
    - Stop the fin-root fillet catching the flap slots. The roots filter
    matched the slots' straight side edges (near-diametral lines at z=0,
    offset only slot_w/2 from centre), rounding every slot mouth and
    blowing the mesh up to ~400k tris. Bound it to the fin radial zone
    (r < drum_wall_r_in); the slots sit out at r~32.
    [drum.py]
2026-07-16 chore(cad): drop unused drum_magnet_boss_fillet param, refresh STL
    [drum-inner.stl]
2026-07-16 feat(cad): prototype two-tone glyph flap generator
    Implements the charset-artwork research recipe: glyph drawn full-size
    (Epilogue Medium, bundled under OFL), split at cap/2, top half on the
    flap front, next char's bottom half on the back via a 180° X rotation,
    ±1mm gap compensation, flush 0.4mm AMS inlays. Demo model 'flap-glyph'
    shows an assembled A plus W/M width-squeeze and Q/? multi-solid checks.
    Note: build123d Text needs text_align=(CENTER, BOTTOM) for a stable
    baseline — the default vertically centres the glyph.
    Claude-Session: https://claude.ai/code/session_01C8HPdCP5x2YeCUp5GNuSB3
2026-07-16 fix(cad): glyph artwork flush to the flap's split edge
    The ±1mm 'gap compensation' offset printed a dead stripe at each
    card's pivot edge, doubling the visible letter gap. The push-apart is
    what the physical hinge gap does on the display; artwork now runs
    flush to the edge. glyph_gap_comp only poses the assembled preview.
    Also guard empty glyph halves (e.g. '.' lives entirely below the
    split) — verified : . $ £ ! ? # ' , all render.
    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
    [glyphflap.py, params.py]
2026-07-16 feat(cad): 52-flap ring, Geist Mono charset, all 52 card 3MFs
    Charset (blank at slot 0 for homing):
    " ABCDEFGHIJKLMNOPQRSTUVWXYZ0123456789:.-?!$£#%°'&/+,"
    drum_flap_count 45 -> 52 (slot web 2.6 -> 2.0 mm at the ring, still
    printable). Font = Geist Mono SemiBold (OFL, bundled; Medium kept as
    alternative). Descender glyphs (Q , /) auto-lift into the top half's
    keepout slack instead of poking past the flap tip. export_flaps()
    writes per-flap two-body colored 3MFs (black card / white glyphs) to
    cad/export/flaps/ for AMS printing; tests pin charset<->drum length,
    slug uniqueness, and per-glyph fit.
    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
    [flap_00_blank.3mf, flap_01_A.3mf, flap_02_B.3mf, flap_03_C.3mf, flap_04_D.3mf, flap_05_E.3mf, flap_06_F.3mf, flap_07_G.3mf]
2026-07-16 feat(cad): flap-set contact sheet model — all 52 fronts + flipped backs
    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
    [catalog.py, glyphflap.py]
2026-07-16 feat(cad): Bambu-native project 3MF export, filaments pre-assigned
    Generic Mesher 3MFs carry display colors only — Bambu Studio ignores
    them for filament mapping (confirmed on import: every part lands on
    filament 1). bambu3mf.py writes the BambuStudio package format instead,
    reverse-engineered from a Bambu 2.5 Save-Project of one flap: meshes in
    3D/Objects/, composite objects/items in 3D/3dmodel.model, per-part
    extruder in Metadata/model_settings.config (card->1 black, glyph->2
    white), vendored P2S 0.4 project profile so plates open slice-ready.
    52 flaps -> 3 plates, 5x5 grid.
    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
    [flaps_plate_1.3mf, flaps_plate_2.3mf, flaps_plate_3.3mf]
2026-07-16 feat(cad): wire flap 3MFs + Bambu plates into 'just cad export'
    'just cad export' (no arg) now also writes the flap artwork; 'just cad
    export flaps' writes only it.
    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
    [flap_00_blank.3mf, flap_01_A.3mf, flap_02_B.3mf, flap_03_C.3mf, flap_04_D.3mf, flap_05_E.3mf, flap_06_F.3mf, flap_07_G.3mf]
2026-07-16 fix(cad): PrusaSlicer-format flap plates — drag-drop into Bambu two-coloured
    Confirmed against David Kingsman's flap 3MFs (which drag into Bambu
    already coloured): they're PrusaSlicer projects, not Bambu-native ones.
    Bambu reads its own model_settings.config only on project-open, so a
    plain Import/drag flattened every part to filament 1.
    Switch the plate exporter to David's format: one merged mesh per flap
    (card triangles then glyph triangles, pre-positioned) with per-volume
    triangle-id ranges in Metadata/Slic3r_PE_model.config, card->extruder 1
    (black), glyph->extruder 2 (white). No print-settings file — Bambu
    keeps the active P2S profile and only takes the extruder assignment.
    Drops t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
    [flaps_plate_1.3mf, flaps_plate_2.3mf, flaps_plate_3.3mf]
2026-07-16 fix(cad): manifold flap meshes via Mesher pipeline, not raw tessellate
    Bambu flagged '240 non-manifold edges' on import and refused to colour
    the parts. Root cause: raw Shape.tessellate() leaves REVERSED faces
    mis-wound, so even a plain card meshed non-manifold. Switch to build123d
    Mesher's _mesh_shape (BRepMesh_IncrementalMesh + orientation-aware
    triangle winding), mesh each part whole, and weld coincident vertices by
    position. All 52 flaps now verify 0 non-manifold edges; regression test
    added.
    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
    [flaps_plate_1.3mf, flaps_plate_2.3mf, flaps_plate_3.3mf]
2026-07-16 fix(cad): Bambu-native multi-component flap export (colours on open)
    Reading BambuStudio's bbs_3mf.cpp settled it: Bambu reads per-part
    colour ONLY from Metadata/model_settings.config, and splits a
    multi-colour object into volumes by SEPARATE COMPONENT MESHES (one mesh
    per volume), never by triangle ranges in a single mesh. So the
    PrusaSlicer Slic3r_PE_model.config route (prev commit) could never
    colour — Bambu ignores that file entirely.
    Rewrite as the structure Bambu's own Save-Project produces (matched
    against a reference save): each part its own mesh in
    3D/Objects/object_1.model, a composite <object> per flap with
    <components>, and <part> extruder assignments in model_settings.config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
    [flaps_plate_1.3mf, flaps_plate_2.3mf, flaps_plate_3.3mf]
2026-07-17 fix(cad): printable M3 head recess on inner drum
    Recess ceiling printed as unsupported annulus (web outer face is the
    bed face). Ease the 6.2->3.4 step with a 45-deg cone; deepen recess
    to 2.0 so the button head sits fully below the web face.
    Claude-Session: https://claude.ai/code/session_012jvg5Z9uamZhNMSqHqa93k
    [drum.py, params.py]
2026-07-17 feat(cad): prototype flap-loading holder jig
    A ring that slips around the drum flap ring with one radial spike per
    flap slot (52), each with an up-turned tip lip. Rest a flap on the
    spike aligned with its slot and thread the side-pins in without it
    flopping while the rest are loaded. New 'holder' model + printable;
    params under holder_*. Prototype dims — iterate against a print.
    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
    [catalog.py, holder.py]
2026-07-17 revert(cad): drop recess-ceiling cone, plain 2.0 counterbore prints fine
    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
    [drum.py, params.py]
2026-07-17 feat(cad): single-face full-character flaps + slotted holder
    Glyph: put the WHOLE character on one face (front) of each flap, back
    blank, instead of splitting top-half/bottom-half across the two faces.
    The split version printed each character half-smooth (up face) and
    half-textured (bed face); single-sided means the whole letter shares
    one finish. Cap height 22mm fits one flap; drops the two-flap split,
    gap-comp, and descender-lift machinery.
    Holder: replace the radial spikes with radial SLOTS — one per flap
    position, 5mm deep, flap-thickness + 0.4mm wide — cut into the ring's
    top face. Flaps drop in edge-first and stand upright for loading.
    Claude-Session: https://claude.ai/code/sessi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
    [flap_00_blank.3mf, flap_01_A.3mf, flap_02_B.3mf, flap_03_C.3mf, flap_04_D.3mf, flap_05_E.3mf, flap_06_F.3mf, flap_07_G.3mf]
2026-07-17 revert(cad): restore split-across-two-flaps glyphs, parity-flip plates
    Characters span two flaps again (top half front of flap N, bottom half
    back of flap N+1) — the single-face version broke the split-flap look.
    Textured-bed fix moves to the plate export instead: odd flaps print
    front-down, even flaps back-down, so both halves of every character
    land on the same plate side and each character gets one uniform finish.
    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
    [flap_00_blank.3mf, flap_01_A.3mf, flap_02_B.3mf, flap_03_C.3mf, flap_04_D.3mf, flap_05_E.3mf, flap_06_F.3mf, flap_07_G.3mf]
2026-07-17 feat(cad): thicken holder base 2.0→3.0mm
    Claude-Session: https://claude.ai/code/session_01T63PQiLBidoXRRm8QRetcE
2026-07-17 feat(cad): log pane under focus viewer, reload dead pages, timestamped watch log
    - third cmux pane tails watch log, panes sized ~3:3:1
    - reload viewer surfaces when viewer restarts (dead websocket left
    pages on OCP demo logo, silently missing pushes)
    - per-line local-time prefix on sync output
    Claude-Session: https://claude.ai/code/session_01NwGzSNwLKuany4nX2DzonP
2026-07-17 feat(cad): command shell split right of watch-log pane
    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
2026-07-17 feat(cad): pose a flap in holder slot 0 in the focus view
    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
2026-07-17 fix(cad): flap-in-slot pose — width axial (vertical), height radial
    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
    [holder.py]
2026-07-17 docs: spec for tools/ctl Go TUI replacing cad shell tooling
    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
2026-07-17 feat(cad): holder slots run full ring width, bottom rim seats drum
    Slots now open at bore and OD; inward flange (slot-floor high) catches
    the drum ring so its underside sits flush with the slot floors. Drops
    holder_slot_len/inset params for holder_rim_w. Re-exported STLs/3MFs.
    [drum-inner.stl, drum-outer.stl, flap_00_blank.3mf, flap_01_A.3mf, flap_02_B.3mf, flap_03_C.3mf, flap_04_D.3mf, flap_05_E.3mf]
2026-07-17 docs: cad refactor plan — abstractions + golden geometry harness
2026-07-17 feat(cad): holder slots full ring width + drum-seat rim, deeper slots
    Slots now run bore to OD (open both ends) so the whole flap edge
    seats; drop slot_len/inset params. Add a bottom rim (inward flange,
    slot-floor high) the drum ring rests on, underside flush with the
    slot floors. Slot depth 5 -> 6.
    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
2026-07-17 docs: cad refactor plan — coordination notes vs ctl TUI plan
2026-07-17 fix(cad): seat preview flap on drum ring top, pin through ring slot
    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
    [holder.py]
2026-07-17 feat(cad): machine-readable list --json for ctl
    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
2026-07-17 feat(ctl): Go orchestrator — cad dispatch, catalog, ports, cmux, view, TUI
    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
2026-07-17 feat(cad): slot-0 indicator triangle on holder top face
    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
2026-07-17 feat(ctl)!: justfile → ctl, delete up.sh, trim python CLI, docs
    pin/sync/state-file removed from splitflap_cad; view/export/list now
    route through the Go ctl. just cad dev/down are gone.
    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
    [flap_00_blank.3mf, flap_01_A.3mf, flap_02_B.3mf, flap_03_C.3mf, flap_04_D.3mf, flap_05_E.3mf, flap_06_F.3mf, flap_07_G.3mf]
2026-07-17 chore(cad): export artifact churn from test runs
    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
    [flap_00_blank.3mf, flap_01_A.3mf, flap_02_B.3mf, flap_03_C.3mf, flap_04_D.3mf, flap_05_E.3mf, flap_06_F.3mf, flap_07_G.3mf]
2026-07-17 docs: refactor plan — post-ctl review updates
    - geo.py gains deboss_mark(): slot-0 triangle now duplicated in
    drum.py and holder.py
    - Phase 3 unblocked: ctl TUI plan fully landed, test_cli.py is the
    list --json contract gate
    - Phase 0 adds deterministic 3MF timestamps (fixes perpetual export
    churn seen in 3958b40, makes L1 export-diff meaningful)
2026-07-17 refactor(ctl): cad menu → view/export submenus
    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
2026-07-17 test(cad): golden geometry harness + deterministic 3MF export
    Phase 0 of docs/plans/cad-refactor.md.
    - tests/golden/: BREP + fingerprint goldens for all fully-ours parts;
    full_unit is fingerprint-only (embeds verbatim vendor STEP geometry —
    license unclear, must not be committed).
    - test_geometry.py: fingerprint guard (volume/area/bbox/COM, default
    run) + XOR-vs-golden-BREP (-m slow). unit-plate defeats OCC booleans
    on its identical twin (coincident faces: empty intersection,
    full-volume residuals) — detected by signature, verified via per-cell
    volume grid instead.
    - threemf.py: deterministic 3MFs. Our plate zips stamped wall-clock
    entry dates; lib3mf (Mesher) randomizes p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
2026-07-17 refactor(cad): geo.py — polar arrays, radial plates, slot-0 marker
    polar()/polar_locs() replace five hand-rolled Rot(0,0,i*360/n) loops;
    radial_plate() extrudes profiles symmetrically so winding direction
    can't flip material placement (deletes the per-site recentring shifts
    and their trap comments in drum.py + unit.py's wedge); slot0_marker()
    unifies the drum/holder deboss triangles.
    Geometry identical: fingerprint + XOR-vs-golden green.
    [drum.py, holder.py]
2026-07-17 refactor(cad): select.py — named edge selectors for drum fillets
    bottom_edges/reach_under/reach_over (bore mouth, hub rim),
    vertical_edges_near_radius (fin-hub seams), diametral_edges_at_z (fin
    roots, r_max guarding the flap-slot side edges). Exact predicates
    preserved; fingerprint + XOR green.
2026-07-17 refactor(ctl): single-program TUI — no alt-screen flash, esc=back, double ctrl+c quit
    One persistent bubbletea program hosts a screen stack (menus, pickers,
    model list) instead of one program per menu, so navigating never
    re-enters the alt screen. First ctrl+c arms a yellow confirm footer
    that clears on any key or after 5s.
    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
2026-07-17 refactor(cad): Scene builder + pure-data catalog
    viewer.Scene replaces five hand-maintained objects/names/colors/alphas
    parallel-list sites (assembly, holder, both glyphflap demos, catalog
    shims) — styling travels with each object, mismatches assert.
    catalog.py is now pure data: Model = (help, src, scene attr),
    Printable = (src, part attr), one lazy loader; the ten wrapper shims
    are gone. Convention: part modules export scene() (+ named extra views)
    and plain part builders. drum_inner_print() moves the print-orientation
    flip into drum.py where its frame is documented.
    list/--json output byte-compatible (ctl contract, test_cli green);
    fingerprint + XOR + full-catalog smoke green.
    [holder.stl, unit.stl]
2026-07-17 refactor(cad): frames.py named poses + params tidy
    frames.py holds every local-frame -> unit-frame transform
    (DRUM_IN_UNIT, MOTOR_IN_UNIT, HALL_PCB_IN_UNIT); drum/assembly posed_*
    compose from it instead of inlining anonymous Pos/Rot chains.
    params: rehomed stranded fields (pilot/screw clearances -> NEMA
    section, drum_flat_clear -> drum bore group), deleted dead
    drum_slot_pitch/holder_slot_pitch (polar() owns pitch now), blessed
    <=1mm cosmetic edge breaks as the one inline-magic exception.
    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
    [drum.py, params.py]
2026-07-17 chore(cad): re-export — deterministic 3MFs, drum STL retessellation
    3MFs: one-time byte churn to the deterministic format (pinned zip
    dates, sequential UUIDs); re-export is now byte-identical. STLs: only
    drum-inner/outer bytes moved (radial_plate's symmetric extrude changes
    B-rep internals -> tessellation); XOR-vs-golden proves the solids are
    unchanged.
    [drum-inner.stl, drum-outer.stl, flap_00_blank.3mf, flap_01_A.3mf, flap_02_B.3mf, flap_03_C.3mf, flap_04_D.3mf, flap_05_E.3mf]
2026-07-17 docs: CAD conventions for the refactored layout; mark plan executed
2026-07-17 fix(cad): 28byj wire box dims — 14.75 wide, 3mm protrusion, flush to can
    Measured: 31mm span from can edge to box outer face = 28 can dia + 3mm
    protrusion (was 5). Width 14.5 -> 14.75. Regen motor-byj golden only.
    Claude-Session: https://claude.ai/code/session_014nzSmRHUKiFdbDizjGNKQE
    [params.py]
2026-07-17 feat(ctl): run export/view inside the TUI
    Actions no longer exit the alt screen: a run screen streams the
    subprocess log under the same header/breadcrumb/footer. esc stops the
    job (view teardown included) and returns to the menu; double ctrl+c
    still quits, waiting for the running job to shut down first. view.go's
    core is extracted as viewJob(model, emit, stop) so the direct CLI path
    and the TUI share it.
    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
2026-07-17 feat(cad): drum printability fixes — fins, lock-screw seat, rib bore
    - fins thicker: thin 1.2→2.0, key 2.7→3.0 (notches/rails derive)
    - fin outer edge stepped: fuses into the inner part's own barrel wall
    over the top 8mm, steps back 0.2 for the free length that docks
    into the outer part
    - lock-screw boss Ø7→Ø9, fuses into the wall; head recess keeps
    1.6 web + 2.0 depth but bottoms in a 45° cone (prints web-down
    with no flat ceiling over air)
    - outer rib bore collapsed to ONE Ø4.2 cylinder (motor-mount idiom),
    rib deepened r16→14.5 so the bore keeps ~1mm wall above the ramp
    - goldens + exports regenerated
    [drum-inner.stl, drum-outer.stl, flap_13_M.3mf, flap_40_qmark.3mf, flaps_plate_1.3mf, flaps_plate_2.3mf]
2026-07-17 fix(ctl): clamp run-screen scroll to lines beyond the window
    Scrolling up when the log fit on screen shifted the tail out of view;
    the clamp now uses len(lines)-logAvail() (also re-clamped on render for
    resizes) instead of len(lines)-1.
    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
2026-07-17 fix(cad): embed 28byj wire box into can so no gap at the round face
    The box's flat inner face only touched the can at one point, gapping at
    the corners. Push the inner face in until it meets the can circle at the
    box's outer corners; box unions into the can. Outer face still stands
    byj_wirebox_d proud.
    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
    [stepper28byj.py]
2026-07-17 fix(cad): 28byj wire box protrusion 3.0 -> 2.75 (30.75mm outer span)
    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
    [params.py]
2026-07-17 feat(cad): rib plan-taper + fatter lock-screw boss
    - outer rib flanks taper at 45° in plan inward of the bore column
    (drum_screw_rib_taper_wall): sheds the wedge's dead inner corner,
    -44mm³ rotating mass; taper faces vertical, no new overhangs; tip
    chamfer moved to the taper-tip vertical edge
    - inner boss Ø9.0→9.4: recess wall 1.4→1.6; edge r27.45 still fuses
    inside the barrel wall; magnet boss gap ~0.45 (limit before merge)
    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
    [drum-inner.stl, drum-outer.stl, flap_07_G.3mf, flap_12_L.3mf, flap_21_U.3mf, flap_22_V.3mf, flap_23_W.3mf, flap_40_qmark.3mf]
2026-07-17 feat(ctl): / fuzzy filter on pick-a-model screens
    Subsequence match (fzf-style) over model names; type to narrow, esc
    clears, enter selects. Typed input is read from KeyRunes so batched
    runes (fast typing / paste) land intact; a batch starting with '/'
    opens the filter pre-filled.
    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
2026-07-17 feat(cad): clip rib belly — pennant profile
    Outer rib underside: 45° down to the deep point under the screw axis,
    then 45° back up to the wall. The belly outward of the bore held
    nothing; bore keeps its 1mm floor at both edges by symmetry. -100mm³,
    both ramps stay printable, rib base rises z21.4→25.4 (more hall-board
    clearance). Goldens + exports regenerated.
    [drum-outer.stl, flap_12_L.3mf, flap_13_M.3mf, flap_14_N.3mf, flap_22_V.3mf, flap_23_W.3mf, flap_31_4.3mf, flap_39_hyphen.3mf]
2026-07-17 feat(ctl): help screen, inverted wheel scroll, filter polish
    - h toggles a help screen listing every binding; the breadcrumb line
    shows just 'help' while it's open
    - mouse wheel now handled directly (WithMouseCellMotion) and inverted:
    wheel up moves down/toward the tail, matching how scrolling feels
    right on this setup
    - filter: opt+delete / ctrl+w kill the trailing word; fuzzy match
    forgives one wrong character on 4+ rune patterns (frap -> flap)
    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
2026-07-17 feat(cad): split flap set into 5 plates (11/plate)
    per_plate 26→11 so the 52-flap set batches across 5 Bambu plates
    instead of 2; re-exported plates 1–5.
    Claude-Session: https://claude.ai/code/session_01QDZsXjexggYJT9XJ7Hp4Un
    [flap_07_G.3mf, flap_12_L.3mf, flap_14_N.3mf, flap_21_U.3mf, flap_22_V.3mf, flap_45_pct.3mf, flaps_plate_1.3mf, flaps_plate_2.3mf]
2026-07-17 Revert "feat(cad): clip rib belly — pennant profile"
    Not what was wanted — rib underside back to the single 45° ramp
    (plan-taper + Ø9.4 boss from 376fdad stay). Exports regenerated on
    the new 5-plate split.
    [drum-outer.stl, flap_07_G.3mf, flap_12_L.3mf, flap_13_M.3mf, flap_21_U.3mf, flap_22_V.3mf, flap_23_W.3mf, flap_44_hash.3mf]
2026-07-17 revert(ctl): drop mouse wheel handling
    Back to the terminal's native alt-screen wheel behavior; text
    selection in the pane works again.
    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
2026-07-17 refactor(cad): split motor-agnostic shell out of unit.py
    unit.py keeps the 28BYJ harness (towers, pad, wire channel, hall post,
    plate windows); shell.py holds the shared plate/walls/rod/guard/lip/
    tab-magnet mods for reuse by the NEMA variant. No geometry change —
    unit goldens pass untouched.
    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
2026-07-17 feat(cad): 4 flap plates + purge stale plates on export
    per_plate 11→13 so 52 flaps batch into 4 plates (13 each).
    export_plates now unlinks old flaps_plate_*.3mf before writing, so a
    smaller batch count no longer leaves orphaned plate files behind.
    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
    [flaps_plate_1.3mf, flaps_plate_2.3mf, flaps_plate_3.3mf, flaps_plate_4.3mf, flaps_plate_5.3mf]
2026-07-17 refactor(cad): truncate rib flat at the bore column
    Plan-taper point → flat vertical inner face at bore edge + 1mm
    (drum_screw_rib_taper_wall → drum_screw_rib_bore_wall). Pure profile
    change — plan-intersect hack deleted; ramp still 45° from the virtual
    r_in, bore floor unchanged. -56mm³. Goldens + exports regenerated.
    [drum-outer.stl, flap_12_L.3mf, flap_13_M.3mf, flap_14_N.3mf, flap_22_V.3mf, flap_23_W.3mf, flap_31_4.3mf, flap_39_hyphen.3mf]
2026-07-17 feat(cad): NEMA pancake harness params + motor model notes
    Pocket-in-plate + printed bridge clamp scheme for the ordered YEJMKJ
    35x21 pancake (face-up inside the drum barrel, shaft coaxial with the
    28BYJ variant). Flat/boss dims marked VERIFY until measured.
    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
2026-07-17 feat(cad): export prints per-model timings
    Each STL/artwork stage is timed; a summary table (+ total when more
    than one entry) lands at the end of the export log.
    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
2026-07-17 fix(cad): goldens + exports for rib truncation
    Prior commit raced a parallel params.py edit; regen crashed and left
    stale goldens. Regenerated clean — all fast+slow tests pass.
    [flap_12_L.3mf, flap_13_M.3mf, flap_22_V.3mf, flap_23_W.3mf, flaps_plate_1.3mf, flaps_plate_3.3mf, flaps_plate_4.3mf]
2026-07-17 chore(cad): re-track flaps_plate_2 — current catalog still emits it
    [flap_12_L.3mf, flap_13_M.3mf, flap_22_V.3mf, flap_23_W.3mf, flap_31_4.3mf, flap_40_qmark.3mf, flap_44_hash.3mf, flaps_plate_2.3mf]
2026-07-17 feat(cad): NEMA pancake unit variant — plate pocket + bridge clamp
    nema_plate: shared shell + body pocket (XY register/anti-rotation) +
    M3 foot screws from below the plate; no lightening windows yet.
    nema_bridge: deck over the motor face (pilot bore + 4xM3 into the
    motor's tapped holes), legs down the +-X flats, insert ankle feet,
    hall-board M2 bosses on the deck (28BYJ hall spot is under the body).
    Clearances audited against the drum sweep: feet r<=25.56 vs wall 26.5,
    deck top 25.5 vs rails from 26.3, bosses top 27 vs fin floor 28.3+.
    Goldens: unit-nema-plate + bridge-nema BREPs, unit-nema-full print.
    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
    [catalog.py, params.py, unitnema.py]
2026-07-17 chore(cad): export NEMA variant STLs
    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
    [bridge-nema.stl, unit-nema.stl]
2026-07-17 feat(cad): single flaps import two-toned; name front+back faces
    Single-flap 3MFs went through Mesher/Color, which Bambu ignores on
    import (colour must be per-part extruder keys in model_settings.config)
    — so they came in mono. Route them through the same Bambu-native writer
    as the plates (a single flap = a one-flap plate); they now drag in
    already black/white.
    Rename flap_<i>_<char> -> flap_<i>_<front><back> (e.g. flap_07_GH) so
    the filename shows BOTH faces the flap carries: front = top of
    CHARSET[i], back = bottom of CHARSET[i+1]. Non-alnum pairs join with _
    (flap_00_blank_A). export_flaps purges stale names before writing.
    Claude-Session: https://claude.ai/code/session_01QDZsXjexggYJT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
    [flap_00_blank.3mf, flap_00_blank_A.3mf, flap_01_A.3mf, flap_01_AB.3mf, flap_02_B.3mf, flap_02_BC.3mf, flap_03_C.3mf, flap_03_CD.3mf]
2026-07-17 feat(cad): flip NEMA foot joint — flush plate inserts, screws from above
    M3x3 heat-set flush into the plate top per foot; M3x6 down through the
    foot (4 foot + 2 engaged, tip stays inside). No through-holes or head
    recesses in the plate — the module's outer face stays untouched. Screw
    axis pushed outboard (r 22.75) so the 2mm hex key clears the leg face
    (0.65) and the deck rim (deck r 21.5 -> 21.0, 0.5). Feet r<=25.66 vs
    wall sweep 26.5. Drum ghost added to the unit-nema scene.
    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
    [bridge-nema.stl, unit-nema.stl]
2026-07-17 feat(cad): NEMA drum inner — shared builder, deeper single-D bore
    drum_inner(shaft): everything shared; only the hub bore differs.
    byj = double-D 9mm (unchanged, XOR-verified); nema = single-D 14mm —
    swallows the 20.5 shaft so the drum keeps the same axial pose
    (engagement 13mm, tip margin 1mm, needs flat >= 13.5 — VERIFY).
    unit-nema scene now shows the NEMA-bore inner. New printable +
    golden drum-inner-nema.
    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
    [drum-inner-nema.stl]
2026-07-17 feat(cad): NEMA side mounts replace the bridge; no pocket; open bore
    Bridge deck killed — the foot bolts' heads couldn't drop past the deck
    rim or the leg face. Instead: two identical side mounts (one part,
    posed 180° apart, print two flange-down with no overhangs): wall up
    each body flat, flange over the face edge with that side's two M3
    holes, foot with a 45° back wedge and a spot-faced Ø7 well down to the
    bolt seat. Whole plan clipped to r 25.5 about the shaft so the outer
    edges run concentric with the drum (flange clipped tighter, r 22.9,
    under the rail sweep). Motor pocket dropped — body sits flat, located
    by the mounts. NEMA drum bore now punches open through hub + web so
    the sh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
    [bridge-nema.stl, drum-inner-nema.stl, mount-nema.stl, unit-nema.stl]
2026-07-17 feat(cad): one-piece bridge back — ring deck joining the side mounts
    Single printed part again per preference: ring deck over the face
    (pilot bore + 4 M3) joining the wall/foot/wedge sides. Bolt drop-in
    solved properly this time: full-height Ø7 well channels cut through
    deck rim, wall face and wedge — bolt + hex key fall straight onto the
    spot-faced seat. Prints deck-down, no overhangs. mount-nema printable/
    golden replaced by bridge-nema.
    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
    [bridge-nema.stl, mount-nema.stl]
2026-07-17 feat(cad): second drum lock screw on opposite quadrant
    Mirror the outer-rib / inner-boss M3 lock joint to drum_screw_ang+180 so
    both sides of the butt joint clamp. The opposite 225-deg web quadrant is
    now solid to back the second boss, leaving lightening windows at 135/315.
    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
    [drum-inner-nema.stl, drum-inner.stl, drum-outer.stl]
2026-07-17 fix(cad): bridge walls follow the deck contour (clip r 22.9)
    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
    [bridge-nema.stl]
2026-07-17 feat(cad): drum-nema model — view the NEMA-bore drum pair
    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
2026-07-17 chore(cad): rename drum/drum-inner -> drum-byj/drum-inner-byj
    Symmetry with the -nema variants; drum-outer stays unsuffixed (shared).
    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
    [drum-inner-byj.stl]
2026-07-17 fix(cad): bridge legs — square-ended walls + solid bolt boss columns
    Arc clip was tapering the wide walls to knife edges and the bolt
    channel scalloped the wall to ~1.4mm slivers. Walls narrowed to sit
    fully inside the deck contour (no taper, full thickness end to end);
    each bolt now runs in a full-height boss column with an open-back
    U-slot — solid material around the whole path, seat prints as a small
    flat bridge. 45° foot wedge obsolete, removed.
    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
    [bridge-nema.stl]
2026-07-17 feat(ctl): multi-select export — space marks rows, enter runs the set
    Export picker (now 'pick a model(s)') marks rows with space, [x]
    checkboxes, marks survive filtering (keyed by name); enter exports the
    marked set, or just the cursor row when nothing is marked. CLI export
    accepts multiple names ('flaps' composes too).
    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
2026-07-17 feat(ctl): export goes straight to the picker; flaps artwork is a row
    'all printables / one model' submenu dropped — cad › export lands on
    the multi-select picker. 'flaps' (3MFs + plates) is a markable row;
    marking every row = the old export-all.
    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
2026-07-17 feat(ctl): home menu — demo + credits placeholders
    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
2026-07-17 style(ctl): bracketed keys in footer help — [esc] back, no slashes
    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
2026-07-17 fix(cad): motor dims from the vendor drawing — shallow taps, real flat
    body 20.2 (±0.8 — measure before printing the bridge), boss 1.6, flat
    16.5 (covers the open bore rule, >=14), tapped holes 2.5 MIN deep: the
    2mm deck + M3x6 would have bottomed out, deck thickened to 3.5 so the
    engagement is exactly 2.5. Deck top 26.7 clears the rail sweep
    radially (r 22.9 < 23.15).
    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
    [bridge-nema.stl, flap_07_GH.3mf, flap_12_LM.3mf, flap_13_MN.3mf, flap_23_WX.3mf, flap_31_45.3mf, flap_44_hash_pct.3mf, flaps_plate_1.3mf]
2026-07-17 feat(cad): bridge walls+bosses rise flush with deck top
    Plan now reads as the deck circle with a tab out each side instead of
    legs stopping under the deck rim.
    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
2026-07-17 feat(cad): bridge legs are solid chord segments
    Wall + bolt boss merge into one slab per side: the full circular
    segment outboard of each body flat, plate top to deck top. Kills the
    triangle gaps between the old boss corners and the mount circle.
    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
2026-07-17 feat(cad): iPad wall-mount side quest — bar viz + 16deg epoxy bracket
2026-07-17 feat(cad): ipad mount — bar flipped wall-end down, centre lock screw
    Bar runs up-and-out; pocket opens on the bracket top face so the bar
    drops in. New lock screw normal to the bar through front wall + bar +
    back skin, head recessed flat — epoxy now optional. Matching drill-
    guide hole in the bar model.
    [ipadwall.py]
2026-07-17 feat(cad): ipad bracket — 4 mounting screws, 2 per tab (#8)
2026-07-17 feat(cad): ipad bracket pocket clearance 0.15/face — snug screw-lock fit
    [params.py]
2026-07-17 feat(cad): ipad bracket — 12deg tilt, rounded wall plate
2026-07-17 feat(cad): ipad bracket tilt 6deg
2026-07-17 feat(cad): ipad bracket tilt 10deg
2026-07-17 feat(cad): ipad bracket — rounded top-front nose (iPad swing clearance)
    [ipadwall.py, params.py]
2026-07-17 feat(cad): ipad bracket tilt 0deg — bar parallel to wall
2026-07-17 feat(cad): ipad bracket — bottom front edge rounded; rigid 14mm mount gap
2026-07-17 feat(cad): ipad bracket two-piece option — channel body + lid, exploded scene
    [ipad-bracket.stl]
2026-07-17 feat(cad): two-piece bracket — full-face lid clamped by the 4 wall screws
    Lid spans the whole plate footprint (same rounded outline); the four
    #8 screws pass through lid + body into the wall, so the lid needs no
    fasteners of its own. Centre lock screw keeps pinning the bar.
2026-07-17 fix(cad): two-piece body is one flush slab out to the bar face — no lip
    [ipadwall.py]
2026-07-17 feat(cad): 4mm head recesses — lid 6mm, bar 1mm closer to wall
    Back skin 1.5mm (drywall backs it); total stack depth stays 12.8.
2026-07-17 refactor(cad): two-piece sandwich replaces one-piece ipad bracket
    Prints: ipad-body + ipad-lid. Old wedge one-piece deleted; unused
    params (plate thick, nose radius) dropped with it.
    [ipad-bracket.stl]
2026-07-17 feat(cad): printed L screw key — slotted driver for the hidden #8 heads
    [ipad-body.stl, ipad-lid.stl]
2026-07-18 revert(cad): drop the L screw key — room under the bracket after all
    [bridge-nema.stl, flap_12_LM.3mf, flap_13_MN.3mf, flap_22_VW.3mf, flap_39_hyphen_qmark.3mf, flap_44_hash_pct.3mf, flap_45_pct_deg.3mf, flaps_plate_1.3mf]
2026-07-18 feat(cad): 1-inch cable grommet — slit barrel plug for the wall hole
2026-07-18 feat(cad): 38mm USB wall-hole grommet — shared slit-grommet idiom in geo
    The iPad grommet's flange+slit-barrel shape moves to geo.slit_grommet
    (dims passed in, frame-agnostic); ipadwall and the new usbgrommet part
    are thin wrappers over it. Goldens regenerated for the new part only —
    ipad-grommet geometry is unchanged by the refactor.
    Claude-Session: https://claude.ai/code/session_01FBUXae1s9YZMR4sg61V8A3
    [usb-grommet.stl]
2026-07-18 refactor(cad): USB grommet v2 — stadium slot, hollow ring barrel
    Slit gone: the small molded USB-C plug threads straight through an
    11x6 stadium slot in the flange. Barrel is now a 2mm-wall locating
    ring, 12mm deep — no solid slug behind the wall face.
    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
    [usb-grommet.stl]
2026-07-18 feat(cad): USB grommet ribs + 11x7 slot — printable triangle profile
    Three triangle ribs on the ring OD, crest 0.8mm proud of the 37mm
    barrel (0.3mm/side bite into the 38mm gypsum bore). Symmetric cone
    faces stay ~33 deg off vertical, so flange-down printing has no
    overhang — the original barb step was a flat 90 deg underside. Slot
    widened to 11x7 per measurement.
    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
    [usb-grommet.stl]
2026-07-18 feat(cad): hall post M2 heat-set insert bores replace self-tap pilots
    Measured insert is 3.0 OD x 3.0 tall; bore is 2.9 so the melt grips.
    Depth stays 8mm — insert seats in the top 3, the rest clears the
    screw tip.
    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
    [unit.stl]
2026-07-18 fix(cad): USB grommet fit rev — 37.75 barrel, 4 ribs, 15 deep, 11x6.5 slot
    Test print sat loose in the 38mm bore: barrel up from 37.0, rib crest
    now 39.75 (0.9mm/side bite). Barrel through the half-inch board with a
    touch proud, fourth rib added, slot height trimmed to 6.5.
    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
    [usb-grommet.stl]
2026-07-18 chore(cad): delete the ipad grommet — superseded by usb-grommet
    Params, builders, catalog entries, golden, and STL all gone; the
    briefly-shared geo.slit_grommet goes with it (usb-grommet grew its own
    ribbed shape).
    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
2026-07-18 fix(cad): USB grommet ribs 0.75 proud — 1.0 was in-only
    Crest 39.25 over the 38 bore: still grips, comes back out. Three ribs.
    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
    [usb-grommet.stl]
2026-07-18 Revert "fix(cad): USB grommet ribs 0.75 proud — 1.0 was in-only"
    This reverts commit 2eff8f1f6b4d87832176ab4ea61187786e3446c6.
    [usb-grommet.stl]
2026-07-18 feat(ctl): golden test in TUI, live catalog, help trim
    Add a "golden test" entry to the cad menu — streams `pytest -m slow`
    (full catalog build + BREP XOR) into the run screen like export does.
    Factored the pipe/scan/SIGTERM plumbing out of startExport into
    streamCmd so both share it.
    Reload the model catalog on every entry to a picker or the list screen
    instead of once at startup, so a catalog.py edit shows up without a
    restart. `list --json` is fast enough that caching it wasn't buying
    anything. A failed reload keeps the last good copy.
    Help: drop the typo-tolerance row (fuzzy filter already implies it) and
    show the quit binding as `ctrl+c` rather than `ctrl+c ctrl+c`.
    Claude-Session: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
2026-07-18 feat(ctl): demo screen — tumbling shaded ASCII cube
    Fills the coming-soon `demo` slot. renderCube is pure (size, angles,
    wireframe) with a 1/z depth buffer and normal-dot-light shading, so it
    tests without a terminal. Spin drifts toward a fresh random target every
    5s rather than being fixed at startup, so the tumble never loops
    visibly. `w` overlays the 12 edges (depth-biased so they win over the
    faces they sit on), `esc` exits and lets the frame loop die.
    Claude-Session: https://claude.ai/code/session_01DfyMck8hkXFqLwtS5p94aK
2026-07-18 feat(pcb): atopile driver board v1 — XIAO C6 socket + ULN2003 + XH conns
    Registry/picker API down (dead ELB): parts vendored locally via easyeda2kicad
    v5->modern converted with faebryk kicad.convert. Bench pinout preserved
    (IN1-4=D0-D3, hall=D8). Skills vendored from mawildoer/atopile-agent-skill.
    Claude-Session: https://claude.ai/code/session_01SmZ7z8NecEFecH7qbexXiX
    [default.kicad_pcb]
2026-07-18 feat(pcb): place driver board v1 + SVG preview renderer
    place_and_render.py: address-keyed placement (survives rebuilds), edge
    cuts, pads/silk/airwire SVG — no KiCad install needed. Parts lib patched:
    'LCSC Part' property needed (at) or faebryk rotate_fp crashes.
    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
    [default.kicad_pcb]
2026-07-18 fix(ctl): cube showed its inside — normals lit the far face
    The camera sits at -z looking towards +z, so a visible face has n.z < 0,
    but the shading negated the dot product and then culled on lum <= 0. That
    scored the +z (far) face as lit and skipped the near one entirely, so the
    depth buffer only ever had back faces to keep: we were looking through
    the cube at its interior.
    Cull on n.z >= 0 instead — an exact back-face test rather than a lighting
    side effect, so a visible face that happens to be grazing can no longer
    punch a hole — and clamp shade to an ambient floor so those faces stay
    dim rather than blank. Test asserts the centre cell's depth is a
    near-side surface across four ori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
2026-07-18 chore(cad): refresh flap and plate 3mf exports
    [flap_07_GH.3mf, flap_12_LM.3mf, flap_13_MN.3mf, flap_14_NO.3mf, flap_21_UV.3mf, flap_23_WX.3mf, flap_31_45.3mf, flap_39_hyphen_qmark.3mf]
2026-07-18 feat(ctl): wireframe is a see-through skeleton, not an overlay
    `w` now drops the faces entirely rather than drawing edges on top of the
    shading, so all 12 edges show including the ones round the back. With no
    faces there is nothing to occlude, so the depth bias that kept edges
    ahead of the surface they sat on goes too.
    Tests: wireframe render contains no ramp chars, and at rest the middle
    row crosses four edges (near pair plus far pair) — two would mean the
    back edges were being hidden.
    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
2026-07-18 feat(ctl): demo opens in wireframe
    Skeleton reads better than the shaded solid at this size; w still
    toggles to shading.
    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
2026-07-18 feat(cad): parametric interconnect fins replace the vendor STEP crop
    The five interconnect tabs were a boolean crop of the gitignored vendor
    STEP — the last vendor geometry in anything we print. Rebuilt as
    parametric solids in fins.py.
    Measured off the crop first. Two things fell out that made this easier
    than expected: there is no frame joining the tabs (five disconnected
    solids, no load path to preserve), and every ramp is a rise-over-run of
    dims we already had rather than a designed angle. The corner gusset the
    old comment called "45-deg" is really a 7mm drop over the 8.78mm fin
    depth; the stack tab's ramp is a genuine 45 because its run is also
    fin_depth. So nothing here states an ang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
    [catalog.py, fins.py, params.py]
2026-07-18 feat(pcb): bulk cap + full hand-routing, 2-layer
    220uF/16V electrolytic (C2887273) on 5V motor rail. Routes in
    place_and_render.py: B.Cu spines/lanes, F.Cu stubs/fans; 0.8mm power,
    0.4mm signal, 0.6/0.3 vias. All nets routed, no airwires left.
    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
    [default.kicad_pcb]
2026-07-18 feat(ctl): render exported STLs as ASCII
    Binary STL loader plus a triangle rasteriser, so the real part from
    cad/export/ can be drawn in the terminal. Triangles fill via barycentric
    coverage with 1/z interpolated across them, so the existing depth buffer
    resolves overlaps per cell rather than per face — necessary once a mesh
    self-occludes, which the cube never did. Stored normals are ignored in
    favour of the winding; exporters write garbage there often enough.
    Meshes normalise to a unit sphere at the origin on load, which is what
    lets the canvas projection stay model-agnostic: newCanvas now takes the
    radius it must fit rather than assuming a cube's diagonal.
    Caught in passing: centring o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
2026-07-18 feat(ctl): tab through the cube and every exported part
    The demo screen becomes a scene list: the cube, then each STL in
    cad/export/ with unit.stl promoted to the front. Tab cycles, w still
    toggles wireframe, and the tumble is shared across scenes so switching
    does not snap the orientation back to rest. Meshes load on first view
    rather than at open, so entering the demo does not pay for 13 exports.
    Also fills a rasteriser gap the cube could never hit: a triangle smaller
    than a cell can slip between cell centres and cover nothing, and at mesh
    density that is most of them — every miss was a pinhole showing the
    inside of the part, which read as speckle across every surface. Falls
    back to the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
2026-07-18 feat(cad): printables use the parametric fins; both full units gain BREP goldens
    Swaps shell.with_vendor_fins for with_fins, so nothing we print reads
    the vendor STEP any more.
    The magnet pads change shape. The old code couldn't add material where
    it wanted it — it only had a cropped vendor solid — so it intersected
    the fin with a box, shifted the slice, and unioned it back to fake a
    thicker arm. Now that we draw the tabs, the pad is just a disc
    concentric with the magnet, inscribed in the tab's 8.78 square: thick
    exactly where the pocket is and nowhere else. That deletes both
    _tab_magnet_mods and _stack_tab_mods along with seven module-level
    constants they needed.
    Pocket sites now com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
    [fins.py, params.py, shell.py, unitnema.py]
2026-07-18 refactor(cad): delete vendor.py — no third-party geometry left
    Last step of the de-vendorization. vendor.py was the only reader of the
    gitignored Unit.stp; with the fins parametric, nothing imports it.
    Goes with it: the assembly's vendor ghost overlay and its have_step
    branch, the "vendor" and temporary "fins-compare" models, and the
    dead vendor_plate_cutouts() (our plate_windows replaced it a while
    back, nothing has called it since).
    Separately dead, found by sweeping the package against catalog.py and
    golden_registry.py as the dynamic entry points: nema_wall_w,
    nema_flange_in, nema_foot_w, byj_can_clear. All four documented, none
    read. They describe the NEMA bridge, which got rebuilt a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
    [unit-nema.stl, unit.stl]
2026-07-18 docs: PCB section in CLAUDE.md — atopile workflow, gotchas, pinout law
    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
2026-07-18 feat(ctl): render any exported part from the cad menu
    The tumbling view was too useful to leave in the demo, so cad gains
    "render": pick a part, watch it spin. The picker lists cad/export/ rather
    than the catalog, since a model with no export has no geometry to draw,
    and says so plainly when the directory is empty.
    Models draw a quarter larger (viewFill), giving up the guarantee that no
    corner can ever leave the grid — clipping is bounds-checked, and presence
    on screen is worth more than a corner that only clips at extreme
    orientations. Arrows walk the scene list, p pauses, w toggles wireframe.
    Wireframe becomes per scene rather than global: twelve edges read as a
    cube, twelve thousand r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
2026-07-18 fix(pcb): lane pitch 0.75mm — KiCad DRC clean (0 err, 0 unconnected)
    KiCad 10.0.4 installed (app copy from brew dmg; cask sudo step fails
    headless). 3D renders via kicad-cli pcb render.
    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
    [default.kicad_pcb]
2026-07-18 fix(ctl): zoom the model out to its guaranteed fit
    viewFill drops from 1.25 to 1.0. Now that the view uses the full terminal
    height rather than 25 rows, a quarter oversize read as cropped-in; at 1.0
    the whole part is in frame with margin, and the fit is provable again
    rather than traded away.
    The fit test now runs at the shipped viewFill instead of a hardcoded 1.0,
    so it guards the value actually in use.
    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
2026-07-18 fix(cad): every fin tab thick enough for its magnet; add invariant tests
    Three bugs in the fins I built, all visible in the viewer, none caught
    by the golden guard.
    The stack tabs' magnet axes were rotated the wrong way — Rot(-y_s*90)
    instead of Rot(y_s*90) — so they pointed out of the module rather than
    into it. Both stack bosses sat entirely in space (290.616 of 290.616
    mm³ unbacked) and their pockets were cut outside any material, leaving
    those tabs with no magnet seat at all.
    The bosses themselves were wrong in principle. I added a full-length
    disc from the mating face, which encloses the tab it sits on, so
    wherever the tab is narrower than the disc the surplus cantilevers off
    an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
    [unit-nema.stl, unit.stl]
2026-07-18 fix(cad): vent the drum hub bore; loosen shaft fit one step
    The byj hub bore is blind (9.0 deep in 15.8 hub + 1.6 web), so pressing
    the shaft home compressed the trapped air. Cut a 2.0 coaxial vent from
    the bore floor out through the web's top face. The nema bore already
    punches through, so the cut is a no-op there.
    Bore clearance 0.2 -> 0.25: the press fought back on the bench. One
    printer-noise step only — the fit must stay a press.
    Goldens regenerated in the same commit.
    Claude-Session: https://claude.ai/code/session_01SXr9ZPN9v6RiHBJp9qYk25
    [drum-inner-byj.stl, drum-inner-nema.stl, flap_07_GH.3mf, flap_12_LM.3mf, flap_13_MN.3mf, flap_14_NO.3mf, flap_22_VW.3mf, flap_31_45.3mf]
2026-07-18 refactor(cad): move the wire tunnel into shell.py
    The buried wire channel is motor-agnostic — cavity, push-in slit and
    flared -X mouth are the same idiom whichever motor feeds it; only the
    centreline and the feed-in x differ. The NEMA plate needs one too, so
    lift it out of unit.py as shell.wire_tunnel(plate, y, x_in).
    unit_plate() is byte-identical: volume 57125.156723, area 41524.755184
    before and after.
    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
2026-07-18 feat(cad): bolt modules together with M3 screws, not magnets
    The six interconnect fins carried 6x3 magnet pockets. Magnets hold
    modules in register but not in tension: a stack can be peeled apart, and
    nothing stops a module creeping along the mating face under the drum's
    start/stop torque. Screws clamp.
    Identical prints mean a site cannot be both halves of a joint, so the
    pattern is antisymmetric: the z=0 and y=-59 faces take the screw
    (clearance + counterbore), the z=53 and y=+59 faces take a heat-set
    insert. The faces that meet when two units stack are always a z=0
    against a z=53, and a +59 against a -59 — so screw always lands on
    insert whichever way round the pair goes, with no handed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
    [fins.py, params.py]
2026-07-18 feat(cad): recess the NEMA, unify the bridge radius, mount the hall
    Four changes to the NEMA variant, which turn out to depend on each
    other:
    Recess the motor 0.4 into a pocket in the plate. The pocket also
    locates the body laterally, which until now only the bridge walls did.
    Everything keys off nema_face_z, so the drop propagates by itself.
    Thin the deck to 2.625 (0.75x), but keep a local boss at each of the
    four screw holes at the old 3.5. The motor's taps are only 2.5 deep
    MIN, so an M3x6 through 2.625 of deck would want 3.375 of thread and
    bottom out before clamping — the deck would get looser, not thinner.
    The boss keeps engagement at exactly 2.5, so the existing screws still
    work.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
    [bridge-nema.stl, unit-nema.stl]
2026-07-18 fix(cad): drop the hall leads through the deck, into a wider trench
    The lead groove ran radially out to the deck rim, which is r 25.5 with
    the barrel wall sweeping 26.5 — a 1.0 gap with a turning drum in it.
    The wires had nowhere to go. They now drop straight DOWN through a
    hole beside the pocket instead. The hole is offset tangentially at the
    sweep radius rather than outboard, which would leave 0.7 of rim wall,
    or inboard, which is the motor body's top face.
    Hole and pocket overlap into one connected cavity (3.22 arc against a
    4.75 half-width sum) so the leads bend out of the head straight down
    without threading a second opening, and the pocket now sinks the
    head's full 1.5 body so it se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
    [bridge-nema.stl, unit-nema.stl]
2026-07-18 feat(cad): refresh flap and plate geometry exports
    [flap_12_LM.3mf, flap_13_MN.3mf, flap_14_NO.3mf, flap_22_VW.3mf, flap_23_WX.3mf, flap_31_45.3mf, flap_40_qmark_bang.3mf, flap_44_hash_pct.3mf]
2026-07-18 chore(cad): drop the ipad-bracket exploded view
    Body + lid printables cover the bracket; the exploded scene earned no keep.
    Claude-Session: https://claude.ai/code/session_012NPqHqug8vdPNMwTUjjcah
2026-07-18 fix(cad): widen the NEMA feed trench for connector housings
    11.0 was sized for two bare bundles side by side. The leads arrive
    crimped: a 4-pin Dupont housing is 10.2 across and a 3-pin 7.6, so
    neither the motor nor the hall bundle could enter without stripping the
    crimp and re-terminating on the far side. 16.0 lets both in staggered.
    Nothing to hit either way — the bridge feet stop at y -17.5 and the
    trench starts at -22.6; the legs only exist at |dx| > 17.6 from the
    shaft and the trench reaches 8.0. Depth is unchanged: already the full
    plate minus the 0.4 outer skin.
    [flap_07_GH.3mf, flap_12_LM.3mf, flap_13_MN.3mf, flap_21_UV.3mf, flap_23_WX.3mf, flap_31_45.3mf, flap_44_hash_pct.3mf, flap_45_pct_deg.3mf]
2026-07-18 fix(cad): counterbore the fin joints on the far face, not the joint line
    The head was sunk into the mating face — the one that gets pressed flat
    against the neighbour's tab. Push two modules together and the screw
    head is sealed inside the joint line: no driver can reach it, so it
    could only ever be tightened before assembly, when it is clamping
    nothing. The screw has to go in from OUTSIDE, cross its tab, and land
    in the neighbour's insert.
    Only the counterbore's face moves. The insert bore stays at the mating
    face (that one really does face the joint — it's the thread the screw
    arrives into), and the thickness budget is untouched: 2.0 counterbore +
    3.0 shank, still an M3x6.
    Every dime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
    [params.py, shell.py]
2026-07-18 feat(cad): lighten the NEMA plate with windows
    The 28BYJ variant has had plate windows since it replaced the vendor
    cutouts; the NEMA plate was still a solid slab. Five chamfered
    rectangles in the house style take 11.1k mm3 out of 33.6k.
    The two variants can't share one set — unit.py's bounds are keyed to
    the tower zone, the can and the hall pedestal, none of which exist
    here. The obstacles on this plate are the bridge and the wire tunnel,
    so the windows are the bands those leave: a pair above the bridge, a
    strip out at -X beside it, and a pair below.
    Both keepouts are grown by plate_web. The bridge reserves its whole
    nema_mount_r disc rather than the two foot patches it actually touches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
    [unitnema.py]
2026-07-18 feat(ctl): wrap the menu cursor at the list ends
    Up from the first row now lands on the last, and down from the last
    returns to the first. Filter mode shares cursorMove so it wraps and
    skips disabled rows too.
    Claude-Session: https://claude.ai/code/session_015QACyw2wYosrfLvrormeum
2026-07-18 fix(cad): stop the NEMA -X window merging into the band above it
    The strip's top edge sat exactly on the +Y band's bottom edge, so the
    two cuts shared a face and fused into one L-shaped opening with a
    knife-edge web where they met. Caught by eye in the viewer, not by any
    test.
    The cause was capping the strip at bridge_hi. That bound belongs to
    the band above, which is held off the bridge disc — but the strip lives
    out at -X where the disc never reaches, so nothing there was actually
    stopping it, and it ran straight up into its neighbour. It stops a
    window margin short of the band instead: the same web the [][] pairs
    already keep.
    test_plate_windows.py is new and asserts the invariants th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
    [unit-nema.stl]
2026-07-18 feat(ctl): port the slot planner to Go
    First step of moving the bench REPL out of python and into ctl. Pure
    transliteration of tools/bench/slotplan.py, with HOME_INDEX becoming a
    field on a `drum` struct rather than a module global.
    One deliberate difference: nearestSlot(2048) — the single step that sits
    exactly between two slots — rounds up here, where python's banker's
    rounding sent it down. The drum is mid-flap either way.
    Claude-Session: https://claude.ai/code/session_01BsYhhQso59hr2n1vVWKz9M
2026-07-18 feat(ctl): bench screen — drive the module over serial
    Ports the python bench REPL into ctl as a `bench` namespace: the serial
    transport and its worker goroutine in bench.go, the screen in
    benchtui.go. Same command surface as before (/home /homecal /zero /pos
    /hall /speed /nudge /sethome /reset /help), same calibration recipe,
    same slot ring and log tail.
    Serial calls block for seconds at a time (HOME sweeps most of a rev), so
    the worker owns the port and the connection state, and the screen only
    draws the snapshots it pushes. Esc is layered: close help, cancel an
    in-flight glyph sequence, then leave.
    The sim transport is gone — the bench is always real hardware. The
    `just up` flash st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
2026-07-18 refactor: retire the python bench REPL
    `just bench` is now ctl's bench screen; `up`, `free`, `ports` and
    `whichport` are folded into it (flash & connect, the port picker) and
    the `port :=` backtick variable goes with them.
    tools/bench/ is deleted — slotplan.py became tools/ctl/slotplan.go last
    commit, bench_ui.py became the bench screen, and the README's findings
    move to docs/research/bench-findings.md where they'll outlive the
    harness. The calibrated home glyph moves to .bench/ (gitignored).
    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
2026-07-18 fix(ctl): seed the bench frame from the saved calibration
    The screen showed a blank home glyph until the board finished its
    handshake, which reads as "uncalibrated" for the ~15s that takes.
    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
2026-07-18 feat(ctl): credits screen — a Star Wars crawl
    The root menu's "credits" entry was a coming-soon stub. Make it a
    perspective text crawl: lines enter full width at the bottom, climb
    toward a horizon as they recede, narrowing and fading through a yellow
    ramp, then loop.
    Two deliberate cheats over honest 1/d perspective: width tapers with
    sqrt of the scale (true 1/d decimates a line into confetti within a
    second of it entering) and squeezing samples destination-to-source, so
    distant text thins evenly instead of losing whichever letters collide.
    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
2026-07-18 feat(firmware): TMC2209 spin test for the NEMA 14
    Standalone-mode driver, so current limit is the trim pot rather than
    software. This board doesn't break Vref out to a header pin, so the pot
    gets set empirically: creep up from minimum, re-running this between
    turns until the motor rotates cleanly.
    Reuses D0-D2 (the old ULN2003 IN1-3 pins) for STEP/DIR/EN.
    Claude-Session: https://claude.ai/code/session_01UQXFTEy3DeBEx85CfiBq9q
    [tmc_spin.py]
2026-07-18 feat(pcb): respin driver board to 45x60 with M3 mounts
    The board had to fit behind a module; the plate is 95x118, so 36x48 was
    never the constraint it looked like. Grow to 45x60 and use the slack:
    every part now has comfortable hand-soldering clearance instead of the
    0.35mm the XH-5 housing had to U1's lower pad row.
    - board 36x48 -> 45x60, four M3 corner holes for heat-set inserts in the
    back shell
    - j_motor rotated 180 -> 0 so the latch faces the board edge and the motor
    cable exits off-board rather than over the chip
    - full re-route: B.Cu carries the four d-signal lanes and both power
    spines, F.Cu carries every power branch, so branches cross lanes on the
    far side
    - board-level s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
    [default-B_Courtyard.gbr, default-B_Cu.gbl, default-B_Fab.gbr, default-B_Mask.gbs, default-B_Paste.gbp, default-B_Silkscreen.gbo, default-Edge_Cuts.gm1, default-F_Courtyard.gbr]
2026-07-18 docs: KiCad 10 is installed — real DRC, renders and gerbers
    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
2026-07-19 feat(pcb): one-shot build script; sign the board
    tools/build_outputs.sh runs place -> DRC -> renders -> gerbers in a single
    call, and refuses to render or ship fab output if DRC fails. --quick stops
    after DRC for a fast loop.
    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
    [default-B_Courtyard.gbr, default-B_Cu.gbl, default-B_Fab.gbr, default-B_Mask.gbs, default-B_Paste.gbp, default-B_Silkscreen.gbo, default-Edge_Cuts.gm1, default-F_Courtyard.gbr]
2026-07-19 feat(ctl): drive the demo view — orbit, zoom, axis snaps, gizmo + HUD
    The demo could only be watched. Now it can be inspected: hjkl or the
    arrows orbit, q/e roll, -/+ zoom, f fits the silhouette to the pane, 0
    resets, and x/y/z snap to an axis (shift for the far side). Any manual
    turn pauses the tumble — the drift otherwise fights every keypress —
    and p lets it go again.
    Scene stepping moves off h/l and the arrows onto [ and ], since those
    keys are worth more as orbit.
    A corner triad shows which way the model's axes point (a label upper
    cases when its axis faces the camera, so a head-on axis still reads),
    and a HUD line carries the part's real bbox in mm, its triangle count,
    the curr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
2026-07-19 feat(ctl): pcb namespace — live 3D viewer, DRC, gerbers
    Third namespace alongside cad and bench, deliberately mirroring cad: same
    port/tab/teardown shape, so both viewers behave identically from the menu.
    - `pcb view` serves tools/viewer/ (three.js, vendored) plus a freshly
    exported board.glb on a free port from 3950, opens a cmux browser tab in
    this pane, and watches place_and_render.py + main.ato. A save re-places,
    re-exports and bumps /rev; the page polls that and reloads itself. Place
    or export failure keeps the last good model up, same as the cad viewer.
    - `pcb drc` / `build` / `place` stream tools/build_outputs.sh into the run
    screen.
    board.glb is generated, so it's gitig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
2026-07-19 feat(pcb): v2 driver board schematic — NEMA 14 + socketed TMC2209
    New atopile project at pcb/driver-board-nema/, leaving the finished v1
    28BYJ-48 board untouched. Single 12V barrel jack feeds the StepStick VM
    directly and a TPS563201 buck makes 5V for the XIAO; the XIAO's own 3V3
    drives the StepStick VIO so the logic levels match.
    atopile's cloud registry is still down, so all 13 new parts are vendored
    by hand (tools/vendor_part.py: easyeda2kicad -> faebryk kicad.convert).
    Two pinouts were verified against primary sources rather than assumed,
    and both would have been wrong otherwise:
    * the SilentStepStick 2x8 is NOT the naive A4988 column order — left is
    GND/VIO/M1B/M1A/M2A/M2B/G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
    [default.bom.csv, default.kicad_pcb]
2026-07-19 feat(pcb): place, route and pour the v2 NEMA driver board
    62x76mm, 2 layers, DRC clean: 0 errors, 0 unconnected, 0 footprint errors.
    GND is a two-layer pour rather than a routed net — it is the right answer
    for a switching regulator, and it removes ~20 hand-routed segments. The
    fill has to happen in KiCad, and `kicad-cli --save-board` rewrites the
    file in a dialect faebryk cannot parse, so the filled board is a derived
    artifact at build/filled.kicad_pcb and layouts/ stays atopile's.
    Numeric checks caught what renders did not:
    * ss_right pin 8 is at x=39.89, not 40.89 — en_n was landing 1mm short
    * r_en_lo.1 is the -x pad; the route was starting on the GND pad
    * l_buck's pins were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
    [bom.csv, default.kicad_pcb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]
2026-07-19 docs(pcb): README for the v2 NEMA driver board
    Pinout, power budget, what to order, assembly order, and the PCBWay
    capability comparison. Also records the one remaining DRC warning and the
    evidence that it is a KiCad reporting artifact rather than real geometry
    (it does not move when the field moves 7.25mm away, and follows the part
    when it is rotated).
    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
2026-07-19 feat(cad): grommet-bathroom blank variant; rename usb-grommet -> grommet-usb
    Shared body builder; USB variant keeps the stadium slot, bathroom
    variant is a blank flange. Goldens + exports regenerated.
    Claude-Session: https://claude.ai/code/session_01GHA7gJ6RuzH6qw3ZjdVNBZ
    [grommet-bathroom.stl, grommet-usb.stl]
2026-07-19 fix(pcb-v2): swap male pin headers for female sockets
    The XIAO and StepStick are modules with male pins soldered in, so the
    board side has to be a receptacle. Kinghelm naming: PH = Pin Header
    (male), FH = Female Header. Both socket parts were PH180, which would
    have given four male headers that cannot mate with anything.
    1x7 (J6/J7, XIAO): C2932700 PH180 -> C2932672 KH-2.54FH-1X7P-H8.5
    1x8 (J4/J5, StepStick): C2905487 PH180 -> C2905417 KH-2.54FH-1X8P-H8.5
    Both verified in stock via the JLCPCB search API (2374 / 3941). Pad
    geometry is identical between the two families -- pin 1 at -7.62/-8.89,
    2.54mm pitch, 1.1mm drill, 1.7mm pads -- so this is a pure part swap
    with no placement or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
    [bom.csv, default.bom.csv, default.kicad_pcb]
2026-07-19 fix(pcb-v1): swap male pin header for female socket
    Same bug as v2: the XIAO socket rows J1/J2 were KH-2.54PH180-1X7P
    (PH = Pin Header, male). The XIAO is a module with male pins soldered
    in, so the board side has to be a receptacle -- FH, not PH.
    C2932700 KH-2.54PH180-1X7P-L11.5 -> C2932672 KH-2.54FH-1X7P-H8.5
    In stock (2374) per the JLCPCB search API. Pad geometry is identical
    between the families, so placement and routing are untouched. DRC stays
    at 0 violations / 0 unconnected; fab package and all five renders
    regenerated.
    Also correct the stale legacy "LCSC Part" property in both boards'
    layouts. atopile writes and maintains "LCSC"; "LCSC Part" is an
    unmanaged leftover that still r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
    [default-B_Courtyard.gbr, default-B_Cu.gbl, default-B_Fab.gbr, default-B_Mask.gbs, default-B_Paste.gbp, default-B_Silkscreen.gbo, default-Edge_Cuts.gm1, default-F_Courtyard.gbr]
2026-07-19 fix(pcb-v2): reverse-polarity FET, socket pitch, and the review backlog
    Two independent reviews found a board that builds and passes DRC but
    would not work. The blockers:
    B1 StepStick socket rows were 15.24mm apart. The 0.6x0.8in figure for a
    StepStick is its BOARD OUTLINE; the pin rows are inset 1.27mm per
    side, so the pitch is 12.70mm. The module physically could not seat.
    ss_right moves 42.00 -> 44.54 (ss_left stays, so the motor block and
    VM bulk keep their routing) and check_socket_pitch() now asserts both
    pitches numerically at place time -- this is the class of error that
    nothing else in the flow catches.
    B2 Q1's source and drain were swapped. A P-FET body diode co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
    [bom.csv, default.bom.csv, default.kicad_pcb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]
2026-07-19 fix(pcb-v2): lift the StepStick label clear of J5's body
    Cosmetic: at y=41.6 it sat under the socket once the row moved to 44.54.
    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
    [default.kicad_pcb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]
2026-07-19 docs(pcb-v2): correct the README's false claims
    The README asserted several things that were not true, some of which
    would have cost a builder a board or an afternoon:
    * "Rows are 15.24mm apart for both the XIAO and the StepStick" -- the
    StepStick's are 12.70mm. Now spelled out, with why the 0.6x0.8in
    figure misleads.
    * Pin 12 was justified as omitted because "the module has its own
    series resistor" on it. It does not: the SilentStepStick fits a 20k
    PULL-DOWN there. Our 1k is still right, for a different reason.
    * Nothing said PDN_UART is NOT connected from the factory. The
    SilentStepStick's 3-way JMP has neither side bridged, so UART
    silently does nothing and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
2026-07-19 chore(pcb-v2): regenerate fab outputs and renders
    Final rebuild from a clean ato build. Geometry is unchanged from the
    previous commit -- the gerber draw commands and aperture definitions are
    byte-identical; only KiCad's redundant aperture-select lines and the
    export timestamp move between runs.
    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
    [default.kicad_pcb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]
2026-07-19 feat(pcb): numeric pre-fab checker shared by both driver boards
    KiCad's DRC ignores the courtyard rules by default, only warns about silk
    over solder mask, and cannot be parsed back by faebryk once kicad-cli has
    written the filled board. verify_fab.py reads the exported board with its
    own s-expression reader and checks courtyards, board extents, silk width
    and silk-into-mask-opening depth numerically.
    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
2026-07-19 fix(pcb): give every footprint an F.CrtYd courtyard
    v1 had courtyards on 5 of 7 footprints, v2 on 4 of 34. KiCad lists
    "Footprint has no courtyard defined" under Ignored checks, so this was not
    a passing body-overlap check -- it was a skipped one, on nearly every part.
    Each courtyard is the union of the component body (the F.Fab outline where
    the vendored footprint has one, else the F.SilkS body) and the land pattern,
    grown by 0.25mm. Deriving from pads alone under-sizes the through-hole
    connectors, whose bodies overhang their pads; deriving from the body alone
    under-sizes every chip part, whose pads overhang its body. The few existing
    courtyards were body-only and did not enclose their own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
2026-07-19 fix(pcb): print the socket body outlines on F.SilkS
    The female receptacles (v1 J3/J4, v2 J4-J7) carried one silk line and four
    F.Fab lines, so the connector body never reached the silkscreen and the
    builder had nothing showing where each socket goes. The body outline moves
    to F.SilkS at 0.15mm.
    It MOVES rather than duplicates: with the same rectangle on both layers,
    atopile's layout sync deduped the F.Fab copies by coordinate and left the
    layout disagreeing with the library, which surfaced as lib_footprint_mismatch
    on all four sockets. F.Fab is not manufactured, and the width-3 strokes it
    used were unusable anyway. The pin-1 tick between pads 1 and 2 and the F.Fab
    pin-1 dot both stay.
    Cour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
2026-07-19 fix(pcb): print polarity on every polarised part
    C6 (470uF, v2) had only a chamfered outline and a 0.03mm F.Fab dot no fab
    will print. It now carries a silk "+" beside pad 1 and a "-" beside pad 2,
    both outside the can outline and clear of the pads.
    The chamfered end is POSITIVE: the SamYoung BXJ J10 case drawing puts the two
    chamfered seating-plate corners on the (+) side and the can-top's solid black
    band on (-). That is the opposite of what a builder reading the physical can
    would assume, which is exactly why it has to be printed.
    D2's cathode symbol was drawn inside the SOD-123 body outline, invisible once
    the part is fitted; D1's only cathode cue was the chamfer on its outline.
    Both g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
2026-07-19 fix(pcb): keep silkscreen out of the solder-mask openings
    Three real cases, found by measuring every silk stroke against every mask
    opening (pad + the board's 0.05mm expansion) rather than by eye:
    - CC0603_100NF drew a "pin 1" dot on F.SilkS, 205um inside pad 1's window.
    A ceramic capacitor has no pin 1 and every other 0603 in these libraries
    keeps that dot on F.Fab, so it moves there. Affected C1/C5/C10 on v2 and
    C2 on v1.
    - XH_4AW (v2 J2) and XH_5AW (v1 J2) draw their body lip flush with the pad
    windows and stepped 65um into them. The step coordinates are pulled clear;
    no move is larger than 0.07mm. Two strokes in XH_5AW coincided exactly
    after the nudge and are dropped, other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
2026-07-19 fix(pcb): make the courtyard checks run, and fix what they found
    build/filled.kicad_pro promotes missing_courtyard, courtyards_overlap and
    malformed_courtyard to errors. KiCad ships the first two as ignored, which is
    why a board with almost no courtyards passed DRC for months. Verified active
    by deleting U1's courtyard and watching DRC fail.
    With courtyards in place the placement self-check found four real overlaps,
    all parts sitting closer than nominal-density assembly spacing:
    d_usb <-> xiao_right 0.42mm body gap -- moved 0.8mm east
    r_fb_hi <-> u_buck 0.46mm -- feedback block moved 0.30mm north
    r_fb_lo <-> u_buck 0.44mm -- and 0.15mm east
    r_hall <-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
    [place_and_render.py]
2026-07-19 feat(pcb): bring v1's build up to v2's
    v1 was DRC-ing layouts/ directly, exporting all 30-odd default gerber layers,
    shipping no BOM or placement file, and cutting its M3 holes as Edge.Cuts
    contours -- which left filled-NPTH.drl empty, so the fab package never
    declared the mounting holes as holes at all.
    It now uses the same shape as the v2 board: a derived build/filled.kicad_pcb,
    courtyard rules promoted to errors, the seven fab layers only, separate
    NPTH/PTH drill, placement CSV, BOM and zip. place_and_render.py gains v2's
    silk-width normalisation (PCBWay's 0.15mm floor), the geometric placement
    self-check, real NPTH mount pads and the 0.05mm mask expansion.
    README was still the atopile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
    [place_and_render.py]
2026-07-19 chore(pcb): regenerate layouts, fab packages and renders
    Both boards: 0 DRC errors, 0 warnings on v1 (four spurious silk_overlap
    warnings remain on v2's C8 -- re-confirmed spurious, they are byte-identical
    with the reference field moved ~24mm away), 0 unconnected pads, 0 footprint
    errors, courtyard checks active and passing, and verify_fab clean.
    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
    [default-B_Courtyard.gbr, default-B_Fab.gbr, default-B_Mask.gbs, default-B_Paste.gbp, default-B_Silkscreen.gbo, default-Edge_Cuts.gm1, default-F_Courtyard.gbr, default-F_Fab.gbr]
2026-07-19 feat(cad): P2S poop bucket XL side quest — parametric remodel
    Rebuild of the downloaded vase-mode chute bucket in build123d:
    depth 1.5x toward the wall, left side +80mm, right side capped at
    old edge + 1in. Chute-fit geometry (spout tube, door notch, 80mm
    top width) measured off the original mesh, verified to 0.24mm worst
    section deviation. All transitions <=45ish deg planar chamfers so
    spiral-vase printing keeps working. Scene ghosts the original-size
    bucket built from the same generator.
2026-07-19 chore(cad): export poop-bucket STL
    [poop-bucket.stl]
2026-07-19 feat(cad): poop bucket detail pass + right side trim
    - spout meets the body wall square (rounds only on the far edge):
    kills the sliver cusps at the joint; stub sized to stay inside
    the original-depth variant's back wall too
    - r3 fillets on all wedge-cut corners (column verticals + sloped
    cut-face edges) — spiral-vase contour never turns a sharp corner
    - 0x63616c maker tag engraved on the printer-side face
    - right wing reach trimmed 25%: 25.4 -> 19.05mm
    [poop-bucket.stl]
2026-07-21 feat(cad): mirror backlight params — measured inputs, derived arch
    Three tape numbers in (34 x 60 x 76in), circular arch out: R and centre
    fall out of chord/rise, and every contour, groove, screw and spool
    dimension derives from there. IN/FT converters live at the top of
    params so imperial never leaks downstream.
    [params.py]
2026-07-21 feat(cad): arched-mirror LED halo — spacers, layout, STEP + drawings
    Side quest. Printed spacers hold the mirror 1.5in off the wall with a
    Hue Solo lightstrip in a groove on their outer face, firing radially
    out so the gap washes the wall.
    - mirrorlight.py: straight + arch spacer, slack spool, posed assembly.
    The strip's easy bend axis is the wall normal, which is exactly the
    pose that aims the emitting face outward — one groove serves both.
    - layout(): spacer counts chosen per segment so every gap lands near
    6in, with half-gap reserves at the straight/arch junction so nothing
    can straddle it or butt up against the first arch spacer.
    - mirrorplot.py: layout elevation + annotated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
2026-07-21 chore(cad): export mirror halo STL/STEP + layout and section renders
    [mirror-light-assembly.step, mirror-slack-spool.step, mirror-slack-spool.stl, mirror-spacer-arch.step, mirror-spacer-arch.stl, mirror-spacer-straight.step, mirror-spacer-straight.stl]
2026-07-21 feat(cad): mirror halo — full wrap, glued spacers, placement jigs
    Reworked off the bench feedback:
    - The strip now runs the WHOLE loop (bottom + two corner turns), because
    the 16.4ft roll cannot be usefully cut and a three-sided path wasted it.
    Bottom corners get a 2in swept spacer: the strip will not turn square.
    - Inset 4in (was 2.2), and the channel rides 4mm off the GLASS rather than
    centred in the gap — the emitter hides until 2 deg off the wall plane.
    - No fasteners. Spacers glue to the frame back and the mirror rests on
    them, so the screw holes and counterbores are gone and z=0 (the bed face)
    is an unbroken bond face.
    - Every part is modelled bond-face-down and the poses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
    [catalog.py, mirrorlight.py, mirrorplot.py, params.py]
2026-07-21 chore(cad): re-export mirror halo spacers, jigs and drawings
    [mirror-jig-arch.stl, mirror-jig-bottom.stl, mirror-jig-corner.stl, mirror-jig-side.stl, mirror-light-assembly.step, mirror-slack-spool.step, mirror-slack-spool.stl, mirror-spacer-arch.stl]
2026-07-21 feat(cad): mirror halo — shallow rebate, slimmer labelled spacers
    - The channel is a 1.5mm locating REBATE, not a pocket: the strip stands
    3mm proud and its own adhesive holds it. Mouth flares 0.6 each side.
    - Spacer block halved to 10mm radial — the 20mm was there to swallow a
    screw counterbore that no longer exists. 27cm3 a straight spacer.
    - Edge breaks on the bed and wall faces, and each spacer carries its own
    name engraved on the wall face (invisible once the mirror is up).
    Swept parts label deeper, on the chord, so it stays on material.
    - Fix: the bottom run's strip ghost sat on the wrong side of its rebate,
    inside the spacers.
    - Fix: _seat() was composed on the LEFT of e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
    [mirror-jig-arch.stl, mirror-jig-bottom.stl, mirror-jig-corner.stl, mirror-jig-side.stl, mirror-light-assembly.step, mirror-spacer-arch.step, mirror-spacer-arch.stl, mirror-spacer-corner.step]
2026-07-21 chore(cad): drop STEP export — STL only
    Nobody downstream reads the STEPs; the build123d source is the model of
    record and STLs are what the slicer eats. Catalog loses the STEP registry,
    export loses its second write, and cad/export/ loses the files.
    [mirror-light-assembly.step, mirror-spacer-arch.step, mirror-spacer-corner.step, mirror-spacer-straight.step]
2026-07-21 chore(cad): drop the mirror placement jigs
    Not wanted. Module, catalog entries, goldens, STLs and the jig-specific
    params all go; the spacer finish params (edge break, mouth flare, label)
    stay, since the spacers use them.
    [mirror-jig-arch.stl, mirror-jig-bottom.stl, mirror-jig-corner.stl, mirror-jig-side.stl]
2026-07-22 feat(cad): storage-box lid clip test coupon
    Side quest: the box lids flex because their side wall is a bare 3mm
    skirt. An inverted-U with a tapered channel (4mm at the closed end,
    2.5mm at the mouth) presses over the skirt and grips as the legs
    relax. 20mm coupon first — check the fit before committing to a full
    lid-length profile.
    [lid-clip.stl]
2026-07-22 chore(cad): halve the lid-clip coupon to 10mm
    [lid-clip.stl]
2026-07-22 feat(cad): lid-clip stack posts, block and rib variants
    The clip alone only stiffens the lid edge; the boxes still stack on the
    lid itself. A post standing on the clip's closed end takes that load
    instead. Height is datumed off the INNER cap face (27.5mm), so it reads
    as true clearance over the lid wall regardless of cap thickness.
    Two widths to test in hand: the full 8mm footprint, and a 4mm rib at
    half the plastic. The lid-clip view shows the bare coupon beside both.
    [flap_12_LM.3mf, flap_14_NO.3mf, flap_21_UV.3mf, flap_31_45.3mf, flap_39_hyphen_qmark.3mf, flap_40_qmark_bang.3mf, flap_45_pct_deg.3mf, flaps_plate_1.3mf]
2026-07-22 chore(cad): drop the rib post — block wins
    [flap_07_GH.3mf, flap_12_LM.3mf, flap_14_NO.3mf, flap_22_VW.3mf, flap_23_WX.3mf, flap_31_45.3mf, flap_39_hyphen_qmark.3mf, flap_44_hash_pct.3mf]
2026-07-22 feat(cad): storage-box corner brace
    Three 30mm square plates meeting at one vertex — the bottom, back and
    left faces of a cube, 2mm thick. Wraps a box corner so the walls can't
    splay, which is the other half of why the stack sags. Corner vertex at
    the origin; prints flat on any one plate.
    [box-corner.stl, flap_07_GH.3mf, flap_12_LM.3mf, flap_13_MN.3mf, flap_14_NO.3mf, flap_23_WX.3mf, flap_40_qmark_bang.3mf, flap_45_pct_deg.3mf]
2026-07-22 feat(cad): 50mm lid-clip coupon with broken edges
    Long enough to feel real lid stiffness, not just the fit. Every profile
    corner gets a 0.5mm round — easier on the nozzle and the rounded tips
    lead the clip onto the wall. The break is the last step on the finished
    solid, so the post fuses to the clip before its edges are broken and no
    notch survives at the joint.
    [flap_12_LM.3mf, flap_13_MN.3mf, flap_14_NO.3mf, flap_22_VW.3mf, flap_23_WX.3mf, flap_31_45.3mf, flap_39_hyphen_qmark.3mf, flap_40_qmark_bang.3mf]
2026-07-22 feat(cad): deeper lid-clip arms, 10 -> 14mm
    Ten was not enough arm to hold the wall. Twelve millimetres of channel
    now, and the gentler taper over that length means the legs splay less
    per millimetre of travel going on — same 2.5mm pinch at the mouth, less
    force to seat.
    [flap_12_LM.3mf, flap_22_VW.3mf, flap_23_WX.3mf, flap_31_45.3mf, flap_40_qmark_bang.3mf, flaps_plate_1.3mf, flaps_plate_2.3mf, flaps_plate_3.3mf]
2026-07-22 feat(cad): 30mm parallel skirt below the lid-clip taper
    The legs carry on straight past the taper at the mouth width, so the
    clip grips a long way down the lid wall without pinching any harder
    than the tips already do. Solid throughout: coring the post and
    windowing the skirt cut ~40% of the plastic but made a simple prism
    fussy to print, which is a bad trade on a part this cheap.
    [lid-clip-post.stl, lid-clip.stl]
2026-07-22 feat(cad): square off the lid clip's outside
    The outer profile was following the channel's taper, which left the
    arms a bare 2mm at the mouth — the one place the bending moment peaks.
    Outer is now a plain rectangle at the widest section run to the tips:
    same channel, same silhouette from the cap down, arms 2.75mm where they
    flex.
    [lid-clip-post.stl, lid-clip.stl]
